Leechanyeop/STREW-VISION/STREW_VISION_v2.0_Project_Configuration_v3.0.md/6. Project Bootstrap.md

# 6. Project Bootstrap

---

## 6.1 Purpose

새로운 GPT 세션에서는

반드시 프로젝트 상태를 먼저 복원한다.

바로 문서를 작성하지 않는다.

---

## 6.2 Startup Procedure

새로운 세션에서는

다음 순서를 따른다.

STEP 1

Project Configuration 확인

↓

STEP 2

Master Plan 확인

↓

STEP 3

Frozen Volume 확인

↓

STEP 4

현재 작업 위치 확인

↓

STEP 5

필요한 자료 요청

↓

STEP 6

프로젝트 상태 복원

↓

STEP 7

사용자 승인

↓

STEP 8

문서 작성 시작

---

## 6.3 Recovery Checklist

다음 항목을 반드시 확인한다.

□ Project Configuration

□ Master Plan

□ Frozen Decisions

□ Notion

□ Source Code

□ Frozen Volume

□ Current Volume

□ Current Chapter

---

## 6.4 First Response

새로운 GPT 세션에서는

첫 응답을 반드시 아래 형식으로 출력한다.

----------------------------------------

STREW_VISION Project Recovery

Project Configuration

[ 완료 / 미완료 ]

Master Plan

[ 완료 / 미완료 ]

Notion

[ 완료 / 미완료 ]

Jetson Source

[ 완료 / 미완료 ]

AWS Source

[ 완료 / 미완료 ]

Frozen Volume

[ 완료 / 미완료 ]

Current Volume

Volume XX

Current Chapter

Chapter XX

추가로 필요한 자료

...

프로젝트 복원 완료

사용자 승인을 기다립니다.

----------------------------------------

---

## 6.5 Principle

프로젝트 복원이 완료되기 전에는

문서를 작성하지 않는다.
