Leechanyeop/STREW-VISION/JETSON_ROBOT/JETSON_NANO_YOLOV5_환경세팅.md

# Jetson Nano 4GB — YOLOv5n 환경 세팅 가이드

## 확인된 하드웨어/OS 정보

| 항목 | 값 |
|---|---|
| 보드 | Jetson Nano 4GB Developer Kit (Maxwell GPU) |
| L4T | R32.7.6 |
| JetPack | 4.6.6 |
| OS | Ubuntu 18.04.6 LTS (bionic) |
| CUDA | 10.2 |
| TensorRT | 8.2.1.8 (이미 설치됨) |
| Python | 3.6.9 (시스템 기본, 절대 3.8로 올리지 않는다 — 이유는 아래 참고) |

**왜 Python 3.6 + torch 1.10 + YOLOv5n인가**: NVIDIA는 Jetson Nano(L4T R32.x/JetPack 4.x) 계열용 CUDA 가속 PyTorch wheel을 Python 3.6까지만 배포한다(1.10.0이 마지막 3.6 지원 버전). Python 3.8용 wheel은 JetPack 5 이상(다른 세대 보드)부터 나온다. 3.8을 쓰려면 PyTorch를 CUDA 10.2에 맞춰 직접 소스빌드해야 하는데, NVIDIA 포럼에도 관련 미해결 질문이 여러 건 있을 만큼 검증된 경로가 아니다. `ultralytics`(YOLOv8+) 패키지는 Python 3.8+를 요구해서 이 보드에서 정식 경로로 못 쓴다 — 그래서 YOLOv5(구 `ultralytics/yolov5` 레포, pip 패키지 아님) + Python 3.6 조합으로 간다.

## 0. 사전 준비 — Swap + 성능 모드

빌드 중간에 메모리 부족으로 죽는 걸 막기 위해 먼저 처리한다.

```bash
# 4GB RAM으로는 torchvision 소스빌드 시 부족할 수 있음 — swap 추가
sudo systemctl disable nvzramconfig
sudo fallocate -l 8G /mnt/8GB.swap
sudo chmod 600 /mnt/8GB.swap
sudo mkswap /mnt/8GB.swap
sudo swapon /mnt/8GB.swap
# 재부팅 후에도 유지하려면 /etc/fstab 에 추가:
# /mnt/8GB.swap none swap sw 0 0

# 최대 성능 모드 (빌드/학습/추론 전부 이걸로)
sudo nvpmodel -m 0
sudo jetson_clocks
```

## 1. 시스템 라이브러리

```bash
sudo apt-get update
sudo apt-get install -y liblapack-dev libblas-dev gfortran libfreetype6-dev \
    libopenblas-base libopenmpi-dev libjpeg-dev zlib1g-dev python3-pip \
    libopenblas-dev libavcodec-dev libavformat-dev libswscale-dev libpython3-dev
```

## 2. Python 패키지 (버전 고정 — Python 3.6 호환 한계선)

```bash
# JetPack 기본 numpy 제거 후 재설치
pip3 uninstall -y numpy
pip3 install numpy==1.19.5     # Python 3.6을 지원하는 마지막 numpy 계열
pip3 install pandas==0.22.0 Pillow==8.4.0 PyYAML==3.12 scipy==1.5.4 \
    psutil tqdm==4.64.1 imutils
sudo apt install -y python3-seaborn
```

## 3. PyTorch 1.10.0 + torchvision 0.11.1

```bash
wget https://nvidia.box.com/shared/static/fjtbno0vpo676a25cgvuqc1wty0fkkg6.whl \
    -O torch-1.10.0-cp36-cp36m-linux_aarch64.whl
pip3 install 'Cython<3'
pip3 install torch-1.10.0-cp36-cp36m-linux_aarch64.whl

git clone --branch v0.11.1 https://github.com/pytorch/vision torchvision
cd torchvision
sudo python3 setup.py install
cd ..

# 확인
python3 -c "import torch, torchvision; print(torch.__version__, torch.cuda.is_available(), torchvision.__version__)"
```

## 4. PyCUDA (TensorRT 엔진을 파이썬에서 실행하려면 필요)

```bash
export PATH=/usr/local/cuda-10.2/bin${PATH:+:${PATH}}
export LD_LIBRARY_PATH=/usr/local/cuda-10.2/lib64:$LD_LIBRARY_PATH
python3 -m pip install pycuda --user
```

## 5. YOLOv5 레포 (pip install ultralytics 아님!)

```bash
git clone --branch v6.2 https://github.com/ultralytics/yolov5
cd yolov5
# requirements.txt에서 torch/torchvision 줄은 지운다 (이미 위에서 설치했으므로 pip이 덮어쓰지 않게)
pip3 install -r requirements.txt
```

## 6. 학습 → TensorRT 엔진 변환

우리 프로젝트는 식물 상태(healthy/powdery_mildew/missing_plant/empty_cell) 4개 클래스로 **직접 학습한 커스텀 가중치**가 필요하다(`nutrition_needed`는 제외 — `robot/planner.py`의 `ACTION_MAP`이 이 4개만 다루고, 매핑 안 된 값은 전부 기본값 `SKIP`으로 빠진다).

**2026-07-15 결정**: 실제로 학습이 끝난 가중치가 YOLOv8(`ultralytics`) 기준 `.pt`로 이미 존재함. 아래 6-A(YOLOv5 전용, mailrocketsystems/JetsonYolov5 기준 — `gen_wts.py`+C++ 빌드)는 v8 가중치의 레이어 구조(anchor-free head, C2f 블록 등)를 못 읽으므로 **이 프로젝트엔 해당 없음**. 대신 6-B(ONNX 경유) 경로를 쓰기로 함 — 시간이 촉박해 v5로 재학습하는 대신, 이미 있는 v8 가중치를 살리는 쪽을 선택. TensorRT 8.2.1.8이 ultralytics의 최신 ONNX export 연산(op)을 전부 지원하는지는 아직 검증 전이며, 6-B 1단계에서 실패하면 `--opset` 낮추기/`onnx-simplifier` 적용/6-A로 회귀(재학습) 중 택해야 함.

### 6-A. YOLOv5 전용 경로 (참고: mailrocketsystems/JetsonYolov5) — 현재 미사용

```bash
# .pt -> .wts 변환
python3 gen_wts.py -w best.pt -o best.wts

# TensorRT 엔진 빌드 (yolov5 C++ 추론 레포 기준)
mkdir build && cd build
cp ../../best.wts .
cmake ..
make
./yolov5_det -s best.wts best.engine n   # n = nano 모델 타입

# 테스트
./yolov5_det -d best.engine ../images
```

### 6-B. YOLOv8 → ONNX → TensorRT 경로 (현재 채택)

1단계는 **젯슨 나노가 아닌 별도 PC**(Python 3.8+, `ultralytics` 설치 가능한 환경)에서 실행한다. 2단계부터는 젯슨 나노(Python 3.6.9, TensorRT 8.2.1.8)에서 실행한다.

```bash
# [별도 PC, Python 3.8+] 1. .pt -> .onnx export
pip install ultralytics
python3 -c "
from ultralytics import YOLO
model = YOLO('best_v8.pt')
model.export(format='onnx', opset=12, simplify=True)
"
# best_v8.onnx 생성됨 -> scp 등으로 젯슨 나노에 복사

# [젯슨 나노] 2. trtexec로 우선 파싱 가능 여부부터 검증
#    (TensorRT 8.2.1.8이 이 ONNX의 연산을 다 지원하는지 여기서 바로 확인됨)
/usr/src/tensorrt/bin/trtexec --onnx=best_v8.onnx --saveEngine=best.engine --fp16

# 실패 시: opset 낮춰서 재export(예: opset=11) 또는 onnx-simplifier 재적용 후 재시도
```

**주의**: `robot/ai/detector/camera.py`의 엔진 로딩 코드(`trt.Runtime().deserialize_cuda_engine()`)는 `.engine` 파일이 어떤 경로(6-A든 6-B든)로 만들어졌든 그대로 읽을 수 있음 — 엔진 로딩 자체는 파이프라인에 무관. 다만 **출력 텐서 구조는 다를 수 있음**: YOLOv5(C++ 레포 기준)는 보통 출력이 여러 개로 분리되어 있는 반면, YOLOv8 ONNX export는 보통 출력이 단일 텐서(`[1, 4+클래스수, N]` 형태, NMS 미포함)로 나옴. 실제 추론 후처리 코드는 `best.engine`이 만들어진 뒤 `self.engine`의 바인딩 개수/shape를 실제로 찍어보고 그에 맞춰 작성해야 함(추측하지 말 것).

## 참고 자료

- [PyTorch for Jetson - NVIDIA Developer Forums](https://forums.developer.nvidia.com/t/pytorch-for-jetson/72048)
- [mailrocketsystems/JetsonYolov5 (Jetson Nano + JetPack 4.6 실제 검증됨)](https://github.com/mailrocketsystems/JetsonYolov5)
- [Faster YOLOv5 inference with TensorRT — Run YOLOv5 at 27 FPS on Jetson Nano (Seeed Studio)](https://www.seeedstudio.com/blog/2022/08/23/faster-inference-with-tensorrt-on-nvidia-jetson-run-yolov5-at-27-fps-on-jetson-nano/)
- [Install PyTorch on Jetson Nano — Q-engineering (swap 관련)](https://qengineering.eu/install-pytorch-on-jetson-nano.html)
