Leechanyeop/STREW-VISION/STREW-VISION_PM_가이드.docx

# STREW-VISION 개발 운영 가이드 (PM)

실제 리포지토리 분석 반영판 · 2026-07-02

# 0. 현재 개발 현황 요약 (Notion 문서 대조 결과)

Notion "#System Setting" 문서와 실제 로컬 리포지토리(C:\STREW_VISION)를 대조한 결과, Jetson Nano 쪽은 문서에 없는 내용까지 포함해 실제로는 더 진행되어 있는 반면, AWS/백엔드·Arduino·대시보드 쪽은 문서상 완성된 것처럼 서술되어 있으나 실제 코드는 대부분 비어 있습니다.

영역 | 문서(Notion) 서술 | 실제 리포지토리 상태 | 판정
Jetson 비전(YOLO) | YOLO는 placeholder 수준 | 학습된 가중치 존재(yolo-train-12), 추론 엔진(ai/detector/engine.py)은 NotImplementedError 스텁 | 문서와 일치 (미완성 맞음)
Jetson 로봇 제어 | strew_robot(main/agent/cloud_client/vision_source/arduino_link) 골격 | 위 파일 모두 존재 + 문서에 없는 robot/ 패키지(uart, packet, protocol, state_machine, task_manager) 추가 발견 | 문서보다 더 진행됨(미문서화)
카메라/센서 | CSI 카메라 + OpenCV 윤곽선 감지만 언급 | IMX708 리눅스 드라이버(11개 파일, 실제 커널모듈) + HuskyLens 컬러 라벨링(251줄) 존재 | 문서에 없는 항목, 실제로는 더 진행됨
AWS_SYSTEM / 백엔드 | FastAPI 7개 API, DynamoDB, Docker, Terraform 완성 | strew-backend/main.py 0줄(빈 파일), requirements.txt만 존재. Terraform/Docker 파일 없음 | 심각한 불일치 – 문서상 완성, 실제는 미착수
Arduino Mega | arduino_mega/strew_mega_receiver.ino 예제 수신부 존재 | strew-arduino/에 README.md, platformio.ini만 존재, .ino/.cpp 소스 없음 | 불일치 – 실제 코드 없음
대시보드 | Node/Express/SQLite 대시보드, API 3종 구현 | strew-dashboard/에 package.json, README만 존재, 소스코드 없음 | 불일치 – 실제 착수 전
아키텍처 문서 | 00_SYSTEM_OVERVIEW.md ~ 05_FILE_MAP.md 존재한다고 서술 | docs/Architecture에 2개 문서만 존재(JETSON_AWS_MEGA_INTEGRATION_PLAN, JETSON_ROBOT_STRUCTURE_SUMMARY) | 불일치 – 서술된 문서 없음
docker-compose.yml | 언급 없음 | 루트에 존재하나 내용 0바이트(빈 파일) | 방치된 빈 설정 파일

결론: 프로젝트 전체를 놓고 보면 "Jetson Nano 파트"가 가장 실체가 있는 영역이며, 오히려 문서에 기록되지 않은 하드웨어 드라이버·로봇 상태머신·YOLO 학습 산출물까지 존재합니다. 반면 문서가 완성됐다고 서술한 백엔드/Arduino/대시보드는 사실상 스캐폴딩(폴더+빈 파일) 수준입니다. 아래 STEP별 가이드는 이 실제 상태를 기준으로 다시 작성되었습니다.

# STEP 1. 프로젝트 목표 정의

프로젝트명: STREW-VISION

목적: 딸기 생육 상태와 질병을 AI Vision(YOLO 객체 탐지 + HuskyLens 컬러 인식)으로 분석하고, Jetson Nano와 Arduino Mega2560을 이용해 로봇이 자동으로 관찰·방제 작업을 수행하는 온실 자동화 시스템 구축

기능 목록

- 잎/열매 검출 (YOLO 기반 – 학습 완료, 추론 파이프라인 미연결)
- QR·컬러 인식 (HuskyLens 기반 – 부분 구현)
- Jetson ↔ Arduino UART 통신 (패킷/프로토콜 – 스캐폴딩 수준)
- 로봇 상태 관리 (상태 머신·작업 관리자 – 구현 진행 중)
- 클라우드 연동 (API 클라이언트 구현, MQTT/동기화 – 미구현)
- 대시보드 모니터링 (미착수)

최종 결과물

Jetson Nano의 실시간 비전 분석 결과를 UART로 Arduino Mega2560에 전달 → Arduino가 로봇 동작(모터/그리퍼 등)을 실행 → 처리 결과를 백엔드·대시보드에 보고하는 통합 온실 자동화 로봇 시스템

개발 범위 (실제 리포지토리 기준)

- JETSON_ROBOT – 비전/AI, 로봇 제어, 클라우드 연동 (가장 진척됨)
- strew-arduino – Arduino Mega2560 펌웨어 (착수 전)
- strew-backend – 서버/API (착수 전)
- strew-dashboard – 모니터링 대시보드 (착수 전)
- strew-hardware – BOM/CAD/PCB/배선 자료
- docs – 아키텍처 문서

# STEP 2. 요구사항 정의 (실제 구현 상태 포함)

AI가 가장 먼저 읽는 문서. 각 요구사항에 현재 구현 상태를 명시해 실제 착수 우선순위를 판단할 수 있도록 함.

ID | 요구사항 | 현재 상태
REQ-001 | 잎을 검출해야 한다 | 부분 구현 – YOLO 학습 데이터/가중치 존재, 추론 엔진 미연결(스텁)
REQ-002 | 열매를 검출해야 한다 | 부분 구현 – 위와 동일
REQ-003 | QR/컬러를 인식해야 한다 | 부분 구현 – huskylens_color_labels.py(251줄) 구현, ai/qr 모듈은 빈 스텁
REQ-004 | Jetson은 UART Packet을 생성한다 | 스캐폴딩 – robot/packet.py(6줄), protocol.py(3줄)만 존재, 실제 포맷/체크섬 로직 없음
REQ-005 | Arduino는 ACK를 반환한다 | 미구현 – strew-arduino에 실제 소스코드 없음(README/설정파일뿐)
REQ-006 | Jetson 로봇은 백엔드 서버와 통신한다 | 부분 구현 – cloud_client.py/api_client.py 존재하나 대상 백엔드(strew-backend)가 비어있어 실연동 불가
REQ-007 | CSI 카메라(IMX708)를 인식해야 한다 | 구현됨 – 리눅스 드라이버 소스 11개 파일 존재
REQ-008 | 로봇은 상태 머신으로 작업을 관리한다 | 구현 진행 중 – state_machine.py(75줄), task_manager.py(19줄)
REQ-009 | 백엔드는 로봇 작업 요청/응답 API를 제공한다 | 미구현 – strew-backend/main.py 빈 파일
REQ-010 | 모니터링 대시보드를 제공한다 | 미구현 – strew-dashboard 소스코드 없음

# STEP 3. 디렉터리 구조 정의 (실제 구조 기준)

Architecture Agent가 설계를 맡되, 아래는 현재 실제 리포지토리 구조와 각 폴더의 실질 역할·완성도임.

폴더 | 역할 | 완성도
JETSON_ROBOT/ai | 비전 처리(YOLO detector, QR/segmentation/tracker) | 대부분 스텁 (camera.py만 실구현 96줄)
JETSON_ROBOT/robot | 로봇 제어(UART, 패킷, 상태머신, 작업관리) | 스캐폴딩~부분 구현
JETSON_ROBOT/cloud | 클라우드/백엔드 통신(API, MQTT, 동기화) | api_client만 구현, mqtt/sync 미구현
JETSON_ROBOT/JETSON | IMX708 카메라 드라이버, HuskyLens 연동 | 구현됨
JETSON_ROBOT/strew_robot | 레거시 로봇 에이전트(main/agent/cloud_client/vision_source/arduino_link) | 구현됨 – robot/ai와 역할 중복, 정리 필요
JETSON_ROBOT/tests | 테스트 코드 + YOLO 학습 산출물 | 학습 산출물(yolo-train-12) 존재
strew-arduino | Arduino Mega2560 펌웨어 | PlatformIO 뼈대만 존재, 코드 없음
strew-backend | 서버/API(FastAPI 등) | main.py 빈 파일, 미착수
strew-dashboard | 모니터링 대시보드 | package.json/README만 존재, 미착수
strew-hardware | BOM/CAD/PCB/배선/데이터시트 | 자료 보유
docs | 아키텍처 문서 | 2개 문서만 존재(Notion 서술과 불일치)
strew-jetson | 용도 불명 – README만 존재 | JETSON_ROBOT과 이름 중복, 정리 대상

주의: strew_robot(레거시)과 robot/ai(신규)가 유사 기능을 중복 구현 중인 것으로 보이므로, Architecture Agent는 다음 작업으로 통합 여부를 먼저 판단해야 함.

# STEP 4. 개발 규칙 정의

신규 코드부터 아래 규칙을 일괄 적용 권장 (기존 스텁 파일 리팩터링 시에도 동일 적용):

- Python 3.10+ (Jetson), Python 3.11 (백엔드)
- PEP8 준수
- Type Hint 필수
- Google Style Docstring – 모든 함수 작성
- Exception 처리 필수 (빈 raise NotImplementedError 상태로 방치 금지)
- print() 금지, logging 사용
- Relative Import 금지
- 빈 스텁 파일은 TODO 주석과 이슈 번호를 명시해 추적

# STEP 5. Agent 역할 정의

### Architecture Agent

- 프로젝트 구조만 설계한다
- 코드는 작성하지 않는다
- 현재 strew_robot ↔ robot/ai 중복 구조 정리안을 최우선 산출물로 제시한다

### Coding Agent

- 설계된 구조만 사용한다
- 새 폴더 생성 금지
- 새 라이브러리 추가 금지

### Validation Agent

- Import, Directory, Dependency, File Missing, API 연결 여부 검사
- 빈 파일(0바이트)·스텁 함수(NotImplementedError) 목록화

# STEP 6. 개발 순서 정의 (현재 진척도 반영 재조정)

기존 예시 순서(Architecture → Vision → Disease → QR → Motion → UART → Arduino → Dashboard → Integration → Deployment)는 Vision/Motion 쪽이 이미 일부 진행된 현재 상태와 맞지 않음. 공백 영역을 우선순위로 재조정:

- 1. strew-backend API 구현 (완전 공백 – 병목 지점)
- 2. strew-arduino 펌웨어 구현 (완전 공백)
- 3. Jetson AI 추론 파이프라인 완성 (ai/detector 스텁 → YOLO 가중치 연결)
- 4. Jetson robot/ 제어 로직 완성 (packet/protocol/motion)
- 5. strew_robot(레거시) ↔ robot/ai 통합 정리
- 6. Cloud 연동 완성 (mqtt, sync)
- 7. Dashboard 구현
- 8. 통합 테스트 → 배포

# STEP 7. AI에게 작업 지시 (예시)

항목 | 내용
Task | strew-backend FastAPI 서버 구현
범위 | strew-backend/
조건 | Python 3.11, FastAPI, Pydantic, Uvicorn
완료 기준 | GET /health, POST /robot/request, GET /robot/next, POST /robot/response 4개 엔드포인트 동작
출력 | JSON REST API

# STEP 8. 구현 후 검증

Validation Agent 검사 항목:

- 파일 누락 여부 (특히 0바이트 스텁 파일)
- Import / Dead Code
- Dependency
- Naming / SOLID
- Exception 처리
- Memory Leak
- 문서(Notion 등)와 실제 코드 상태 일치 여부 – 이번 대조에서 드러난 것처럼 정기적 대조 필요

# STEP 9. 수정

Review Agent → 문제점만 작성 (코드 수정 금지)

Coding Agent → Review 결과만 수정

# STEP 10. 최종 통합

Integration Agent 검사 항목: UART, Vision, Motion, Arduino, Dashboard, Database, Logger

현재 상태 기준 통합 전 필수 선행 작업: strew-backend/Arduino 실제 구현, strew_robot↔robot 중복 제거

# STEP 11. 최종 테스트

Vision → QR → Task → Motion → UART → Arduino → Servo → DONE (성공하면 Release)

# 핵심 역할

역할 | 사람(PM)이 할 일 | AI가 할 일
PM | 요구사항 정의 | -
Architect | 전체 구조 승인 | 구조 제안
Task Manager | 작업 분배 | 작업 수행
Reviewer | 결과 승인 여부 결정 | 리뷰 결과 생성
Integrator | 최종 통합 판단 | 통합 지원

# 추천 운영 사이클

- ① 요구사항 작성
- ② Claude Code (설계/분석)
- ③ Codex (구현)
- ④ Claude Code (리뷰/검증)
- ⑤ Codex (수정)
- ⑥ Claude Code (최종 승인)
- ⑦ Git Commit
- ⑧ 다음 기능 개발

# 가장 중요한 원칙

AI에게 "코드를 만들어줘"라고 지시하기보다, "무엇을 만들고, 어떤 제약을 지켜야 하며, 완료 기준이 무엇인지"를 먼저 정의하는 것이 핵심이다.

매 기능마다 다음 5가지를 먼저 정하면 결과 품질이 크게 좋아진다:

- 목표: 무엇을 구현하는가?
- 입출력: 입력과 출력은 무엇인가?
- 제약: 사용할 기술, 금지 사항, 코딩 규칙은?
- 완료 기준: 언제 구현이 끝났다고 볼 것인가?
- 검증 방법: 어떤 테스트를 통과해야 승인할 것인가?

이 다섯 가지를 기준으로 Claude Code에는 설계와 검증을, Codex에는 구현을 맡기면 프로젝트를 훨씬 안정적으로 운영할 수 있다.
