Leechanyeop/STREW-VISION/docs/25년_SW개발_HW제작설계서_응용하드웨어(개인정보 기재x).pptx

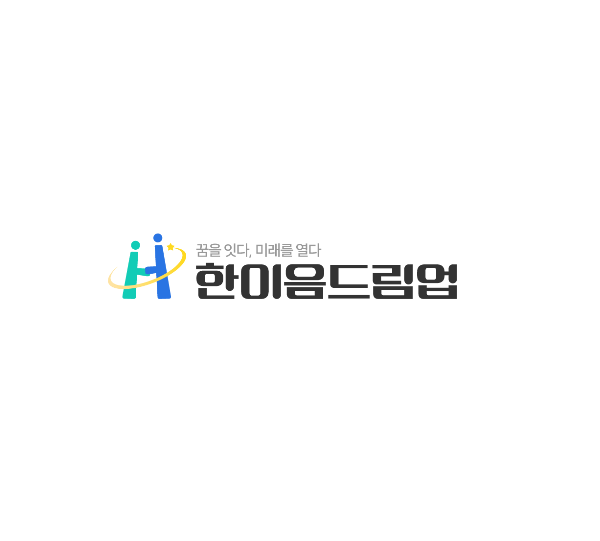
[picture p1: figure]

SW개발/HW제작 설계서
STREW_VISION ARCHITECHER
SW/HW DEVELOPMENT

프로젝트 명 : STREW_VISION

## Slide 2

수행 단계별 주요 산출물

단계 | 선정 산출물 | 우선 | 구체화 필요도 | 비고
환경 분석 | 시장/기술 환경 분석서 | △ | 중 | 농업 인력난, 병해충 조기 대응, 스마트팜 동향 중심
요구사항 분석 | 요구사항 정의서 | ◎ | 상 | S/W, H/W, 운영자 요구사항을 기능 ID로 연결
요구사항 분석 | 유즈케이스 정의서 | ◎ | 상 | 운영자, ,Jetson, 로봇 제어부 역할 정의
아키텍처 설계 | 시스템 구성도 | ◎ | 상 | 센서 → STM32 → Jetson → DB → 로봇제어부 흐름
아키텍처 설계 | 데이터 흐름도 | ◎ | 상 | 주행 시작부터 검사/로그 저장까지 이벤트 흐름
아키텍처 설계 | 하드웨어/센서 구성도 | ◎ | 상 | 온습도 센서 4개, 리미트 스위치 4개, 카메라, 제어부
기능 설계 | 화면 설계서 | ○ | 중 | 위치, 센서값, 검사결과, 로그, 비상정지/재개 UI
기능 설계 | ERD/테이블 정의서 | ◎ | 상 | pot, sensor_reading, robot_position_log, vision_inspection_log 등
기능 설계 | 기능 처리도 | ◎ | 상 | ARRIVED → PLANT_ID → 비전검사 → 판정 → 로그
기능 설계 | 알고리즘 명세서 | ◎ | 상 | LIMIT 매핑, 검사 조건, discard 판단, 예외 처리
개발/구현 | 프로그램 목록 | ○ | 중 | COM/POS/SNS/VIS/DEC/CTRL/LOG 모듈 목록
개발/구현 | 핵심 소스코드 | ◎ | 상 | STM32 수신, 식물 ID 판별, 비전 검사, STOP/RESUME 처리
검증 | 비상정지/재개 시나리오 | ◎ | 상 | 안전 우선순위와 재개 전 위치 재확인

※ ○ 필수, △ 선택

## 환경 및 요구사항 분석

한이음 ▶ 프로그램 설계서

## Slide 4

| 시장/기술 동향 분석

작성 범위 세분화

시장/기술 동향 분석은 “범위 정의 → 시장 Fact → 기술 Fact → 종합 판단” 순서로 작성

각 슬라이드는 객관적 근거 제시, 정량·정성 병행, 마지막 사업화 시사점 도출이라는 동일한 작성 원칙을 따릅니다.

분석 목적·범위

대상 시장, 고객군, 지역, 적용 제품/서비스를 먼저 고정

시장 동향

시장 규모, 수요 변화, 경쟁 구도, 정책·규제를 정리

기술 동향

핵심 기술, 성숙도, R&D·특허·표준, 구현 이슈를 정리

종합 판단

시장 매력도와 기술 실현 가능성을 교차 평가해 실행 제언 도출

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
작성 체크포인트: 출처/기준연도 명시 · 비교 대상 통일 · Fact와 해석 분리 · 기회/위험을 실행 과제로 연결

## Slide 5

| 시장/기술 동향 분석

단순 현황 나열보다 “왜 지금 진입해야 하는가 / 어디가 유망한가
/ 무엇이 리스크인가”가 드러나야 합니다.

A. 시장 규모·성장성

필수 근거
• 공신력 있는 통계/보고서/시장조사 자료
• 최근 3개년 매출·투자·수출입·정책 변화
• 고객/경쟁사 사례 또는 실제 적용 레퍼런스

향후 3~5년간 스마트팜 시장은 단순한 환경 모니터링(1세대)을 넘어, '에지 AI + 로봇 제어 + 클라우드'가 결합된 지능형 자동화(2~3세대) 단계로 진입하며 매년 두 자릿수(11%~15%)의 높은 CAGR을 기록할 것으로 강력히 전망됩니다.

B. 고객 수요·구매 요인

• 전체 시장 규모: 기준연도, 지역, 금액/수량 단위
• 성장성: CAGR, 3~5년 전망, 성장 요인
• 세그먼트: 고객군·용도·가격대별 비중
• 근거: 통계청, 산업보고서, 협회/공공 데이터

산출물 예시
시장 매력도 평가표 | 경쟁사 포지셔닝 맵 | 진입 우선순위

작성 문장 예시: “OO 시장은 △△ 수요 증가와 □□ 정책 지원으로 성장성이 높으나, 인증·유통 장벽이 초기 진입 리스크로 작용한다.”

## Slide 6

| 시장/기술 동향 분석

세부 양식 ①

단순 현황 나열보다 “왜 지금 진입해야 하는가 / 어디가 유망한가 / 무엇이 리스크인가”가 드러나야 합니다.

B. 고객 수요·구매 요인

필수 근거
• 공신력 있는 통계/보고서/시장조사 자료
• 최근 3개년 매출·투자·수출입·정책 변화
• 고객/경쟁사 사례 또는 실제 적용 레퍼런스

• 핵심 고객: B2B/B2C, 의사결정자, 사용 부서
• Pain Point: 비용, 품질, 납기, 안전, 편의성
• 구매 요인: 가격 민감도, 인증, 브랜드, 사후관리
• 변화 신호: 검색량, 입찰/수주, VOC, 레퍼런스

산출물 예시
시장 매력도 평가표 | 경쟁사 포지셔닝 맵 | 진입 우선순위

작성 문장 예시: “OO 시장은 △△ 수요 증가와 □□ 정책 지원으로 성장성이 높으나, 인증·유통 장벽이 초기 진입 리스크로 작용한다.”

## Slide 7

| 시장/기술 동향 분석

세부 양식 ①

단순 현황 나열보다 “왜 지금 진입해야 하는가 / 어디가 유망한가 / 무엇이 리스크인가”가 드러나야 합니다.

C. 경쟁 구도·대체재

필수 근거
• 공신력 있는 통계/보고서/시장조사 자료
• 최근 3개년 매출·투자·수출입·정책 변화
• 고객/경쟁사 사례 또는 실제 적용 레퍼런스

산출물 예시
시장 매력도 평가표 | 경쟁사 포지셔닝 맵 | 진입 우선순위

• 주요 기업: 점유율, 제품군, 가격, 채널
• 경쟁 우위: 기술, 원가, 브랜드, 파트너십
• 대체재/보완재: 기존 방식 대비 강·약점
• 비교 산출물: 경쟁사 포지셔닝 맵

작성 문장 예시: “OO 시장은 △△ 수요 증가와 □□ 정책 지원으로 성장성이 높으나, 인증·유통 장벽이 초기 진입 리스크로 작용한다.”

## Slide 8

| 시장/기술 동향 분석

세부 양식 ①

단순 현황 나열보다 “왜 지금 진입해야 하는가 / 어디가 유망한가 / 무엇이 리스크인가”가 드러나야 합니다.

D. 정책·규제·진입장벽

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

C. 경쟁 구도·대체재

• 정책/지원사업: 정부 과제, 보조금, 공공조달
• 규제/인증: 표준, 안전, 환경, 개인정보
• 진입장벽: 설비투자, 유통망, 전환비용
• 최종 판단: 기회·위험·대응 전략

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

## Slide 9

| 시장/기술 동향 분석

딸기 스마트팜 시장은 겨울철 고품질 딸기 수요 증가와 정부의 청년·창업농 정책 지원으로 성장성이 높으나, 초기 고액의 시설 구축 비용과 ICT 인증 기자재 수급 장벽이 초기 진입 리스크로 작용한다.”

작성 목적: 시장 매력도와 기술 실현 가능성을 동시에 검토하여 사업화 우선순위를 판단

② 기술 동향 작성 항목

1) 핵심 기술 정의: 기술 원리, 구성요소, 적용 범위
2) 성숙도: TRL, 상용화 수준, 성능/원가/품질 지표
3) R&D 흐름: 논문·특허·표준화·정부 과제 동향
4) 주요 플레이어: 선도 기업/기관, 보유 기술, 협업 구조
5) 구현 이슈: 개발 난이도, 공급망, 보안·안전·인증 이슈
6) 시사점: 확보 전략, 내재화/제휴/도입 판단 기준

필수 근거
• 특허·논문 증가율, 표준/인증 변화
• 벤치마크 성능, 원가 구조, 양산 가능성
• 경쟁 기술 대비 우위·한계 및 대체 가능성

산출물 예시
기술 성숙도 매트릭스 | 특허/논문 트렌드 | 확보 로드맵

최종 작성 구조: ① 분석 배경 → ② 시장/기술 Fact → ③ 경쟁·규제 비교 → ④ 기회/위험 → ⑤ 실행 제언

## Slide 10

| 시장/기술 동향 분석

기술 설명은 원리보다 사업화 판단에 필요한 성능, 원가, 특허/표준, 구현 리스크 중심으로 정리합니다.

기술 동향은 성숙도와 확보 가능성을 분리해 “내재화·제휴·도입” 판단으로 연결합니다

A. 기술 정의·성숙도

1) 핵심 기술 정의
- 기술 원리, 구성요소, 적용 제품/서비스
- 기존 기술 대비 차별점

2) 성숙도·상용화 수준
- TRL, 양산/실증 여부, 레퍼런스
- 성능·원가·품질 기준 및 벤치마크

3) 구현 이슈
- 공급망, 장비/소재, 보안·안전·인증
- 개발 난이도와 예상 소요 기간

B. R&D 흐름·확보 전략

1) R&D·특허·논문 동향
- 최근 3~5년 출원/발표 증가율
- 주요 출원인, 기술 분류, 표준화 움직임

2) 주요 플레이어·협업 구조
- 선도 기업/기관, 파트너십, 공급망 위치
- 보유 기술과 약점 비교

3) 확보 전략
- 자체 개발, 공동개발, 라이선스, M&A
- 비용·기간·리스크 기준 우선순위

산출물: 기술 성숙도 매트릭스 / 성능 비교표 / 구현 리스크 목록

산출물: 특허/논문 트렌드 / 기술 확보 로드맵 / Make-Buy-Partner 판단표

## Slide 11

| 요구사항 정의서

요구사항 ID | 요구사항명 | 상세 내용 | 입력 데이터 | 처리 내용 | 출력 결과
FR-01 | 하우스 온·습도 측정 | 온·습도 센서를 통해 하우스 내부 환경 데이터를 측정한다. | 온도 센서값, 습도 센서값 | 센서 데이터 수집 및 변환 | 온도·습도 측정값
FR-02 | 상위 제어 명령 수행 | 상위 제어기에서 전달된 작업 명령을 수신하고 로봇 동작 명령으로 변환한다. | 상위 제어 명령 | 명령 해석 및 동작 변환 | 로봇 제어 명령
FR-03 | 6축 로봇 제어 | 6축 로봇을 지정 위치로 이동시켜 보식 작업을 수행하도록 제어한다. | 좌표값, 작업 명령 | 로봇 경로 생성 및 위치 제어 | 로봇 이동 및 작업 수행
FR-04 | 식물 보식 여부 판단 | 식물 삽입, 위치 정렬, 작업 완료 여부 확인 등 실제 보식 동작을 처리한다. | 보식 대상 위치, 식물 정보 | 식물 삽입 및 정렬 작업 수행 | 보식 완료 결과
FR-05 | 비전 인식 촬영 제어 | 비전 센서가 바코드와 식물을 인식할 수 있도록 촬영 위치와 모션을 제어한다. | 촬영 위치, 모션 명령 | 카메라 위치 제어 및 촬영 수행 | 바코드·식물 이미지
FR-06 | 인식 데이터 연동 | 바코드 및 식물 인식 결과를 상위 시스템에 전달하고 작업 이력으로 저장한다. | 바코드 인식값, 식물 인식 결과 | 데이터 전송 및 이력 저장 | 인식 결과, 작업 이력 데이터

## Slide 12

| 요구사항 정의서

FR-06 | 생장 환경 최적화 제어 | 측정된 온·습도 값을 목표값과 비교하고 PID 제어를 수행한다. | 온도, 습도, 목표 설정값 | PID 제어 알고리즘 수행 | 냉난방기, 가습기, 환풍기 제어 명령
FR-07 | 이상 상태 알림 | 위험 상태 또는 병해충 발생 시 관리자에게 알림을 전송한다. | AI 분석 결과 | 이벤트 감지 및 알림 생성 | 앱 알림, SMS, 경고 메시지
FR-08 | 데이터 저장 및 이력 관리 | 센서 데이터 및 분석 결과를 데이터베이스에 저장한다. | 센서 데이터, 분석 결과 | DB 저장 및 이력 관리 | 조회 가능한 이력 데이터

## Slide 13

| 요구사항 정의서

요구사항 ID | 요구사항명 | 상세 내용
NFR-01 | 실시간성 | 센서 데이터는 1분 이내 주기로 갱신되어야 한다.
NFR-02 | 정확성 | AI 병해충 판별 정확도는 90% 이상이어야 한다.
NFR-03 | 안정성 | 시스템 가동률은 99% 이상을 유지해야 한다.
NFR-04 | 사용성 | 관리자 화면에서 모든 셀의 상태를 한 화면에서 확인할 수 있어야 한다.
NFR-05 | 보안성 | 사용자 로그인 및 권한 관리 기능을 제공해야 한다.

## Slide 14

| 요구사항 정의서

요구사항 ID | 요구사항명 | 상세 내용
NFR-01 | 측정 정확성 | 온·습도 센서는 일정 오차 범위 내에서 하우스 환경을 측정해야 한다.
NFR-02 | 제어 응답성 | 상위 제어 명령 수신 후 로봇 동작 명령으로 빠르게 변환되어야 한다.
NFR-03 | 동작 안정성 | 6축 로봇은 지정된 작업 범위 내에서 안전하게 동작해야 한다.
NFR-04 | 인식 정확성 | 바코드 및 식물 인식 결과는 작업 처리에 활용 가능한 수준의 정확도를 가져야 한다.
NFR-05 | 이력 관리 | 보식 작업 결과와 인식 데이터는 추후 조회가 가능하도록 저장되어야 한다.

## Slide 15

| 요구사항 정의서

요구사항 ID | 요구사항명 | 상세 내용 | 입력 데이터 | 처리 내용 | 출력 결과
FR-01 | 하우스 식물 온·습도 상태 조회 | 최근 7일간 누적된 온도 및 습도 데이터를 조회하고 그래프로 시각화한다. | 온도 센서 데이터, 습도 센서 데이터 | 일별 데이터 수집 및 그래프 생성 | 온도·습도 추이 그래프
FR-02 | 식물셀 상시 모니터링 | 4개 식물셀의 상태를 실시간으로 감시하고 병해충 발생 여부를 확인한다. | 카메라 영상, 환경 센서 데이터 | 이미지 분석 및 상태 판별 | 식물 상태 정보, 병해충 발생 알림
FR-03 | AI 드라이브 자동 판단 | 설정된 임계값을 초과한 경우 AI가 자동으로 상태를 분석하여 위험 여부를 판단한다. | 환경 데이터, 식물 상태 데이터, 임계값 | AI 모델 기반 위험도 분석 | 정상/주의/위험 상태 결과
FR-04 | 보식 작업 결정 | AI 분석 결과를 기반으로 문제가 발생한 식물셀의 보식 필요 여부를 결정한다. | AI 분석 결과, 식물 상태 정보 | 보식 필요성 판단 알고리즘 수행 | 보식 필요 여부 및 대상 셀
FR-05 | 성장률 및 생산성 분석 | 보식 날짜를 기준으로 식물셀별 평균 성장률과 전체 생산성을 계산한다. | 보식 이력, 생육 데이터 | 성장률 계산 및 생산성 분석 | 셀별 성장률, 생산성 지표

## Slide 16

| 유즈케이스 정의서

사용자가 시스템으로 무엇을 하는지 시나리오로 정리

UC-01 온실 환경 확인 및 제어

기본 정보

관리자가 온실 상태를 확인하고 필요 시 제어한다

농장 관리자 / 운영 담당자

관리자가 시스템에 로그인되어 있음

현재 상태 확인 또는 제어 명령이 정상 반영됨

기본 흐름

1. 대시보드에서 온실 선택
2. 온도·습도·CO₂·조도 확인
3. 이상 항목 경고 확인
4. 관수/환기/난방 제어 실행
5. 실행 결과와 이력 저장

예외/확장

• 센서 값 미수신 시 데이터 없음 표시
• 장비 응답 실패 시 재시도 및 알림
• 자동제어 모드에서는 기준값에 따라 실행

목적

사용자

시작 조건

완료 조건

유즈케이스 → 사용자 행동 흐름 정리 → 기능 요구사항 도출의 근거

핵심: 유즈케이스는 “사용 장면과 흐름”을 보여준다.

## Slide 17

| 요구사항 정의서

시스템이 제공해야 할 기능과 품질 조건을 목록으로 정의

딸기 스마트팜 시스템 요구사항 예시

기능 요구사항

온실별 환경 데이터를 조회할 수 있어야 한다

기준치 이탈 시 관리자에게 알림을 발송해야 한다

관수·환기·난방 장치를 수동/자동 제어해야 한다

생육·환경 데이터를 기간별 그래프로 제공해야 한다

비기능 요구사항

NFR-01 센서 데이터 5분 단위 수집
NFR-02 모바일/PC 동일 기능 제공
NFR-03 장애 발생 시 1분 내 알림
NFR-04 사용자 권한별 접근 제한
NFR-05 제어/알림 이력 1년 보관

검수 기준

• 테스트 계정으로 데이터 조회 확인
• 임계값 초과 시 알림 수신 확인
• 제어 명령 후 장비 상태 변경 확인
• 요구사항별 우선순위와 담당자 지정

FR-01

FR-02

FR-03

FR-04

요구사항 → 기능/품질 조건 확정 → 설계·개발·검수 기준으로 사용

핵심: 요구사항 정의서는 “만들 기능과 조건”을 확정한다.

최종 산출물: 요구사항 목록표 + 유즈케이스 상세표 + 요구사항-유즈케이스 추적표

## 시스템 아키텍쳐설계 (system architecture configuration)

## Slide 19

| 서비스 구성도 - 서비스 시나리오

## Slide 20

서비스 구성도 – 시스템 계층

시스템은 총 9개 계층으로 구성됨.
1.물리/필드 계층 - 딸기 작물, 화분, 레일 등 실제 농장 환경
2.로봇/제어 계층 - 자율주행 로봇과 로봇 팔을 제어한다.
3.센서/수집 계층 - 카메라와 센서로 이미지와 위치 정보를 수집.
4.인식 계층 - QR코드를 통해 화분 ID를 식별.
5.AI 분석 계층 - 작물 이미지를 분석하여 병해충 여부를 판단.
6.데이터/저장 계층 - 분석 결과와 작업 이력을 DB에 저장.
7.응용 계층 - 자동 관리 사이클과 작업 로직을 처리.
8.서비스/관제 계층 - 웹/모바일 화면으로 상태를 시각화.
9.사용자 계층 - 관리자가 확인과 의사결정을 수행.

## Slide 21

서비스 흐름도 - DATA FLOW

## Slide 22

| 참조-개발 환경 및 설명

구분 | | 항목 | 적용내역
H/W 구성장비

## Slide 23

| 참조-개발 환경 및 설명

구분 | | 항목 | 적용내역
H/W 구성장비

## Slide 24

| 참조-개발 환경 및 설명

구분 | | 항목 | 적용내역
S/W 개발환경 | SDK 공동 개발 | VSCode | 본 프로젝트에서는 소스코드 작성과 프로젝트 파일 관리를 위해 VSCode를 사용한다. VSCode는 다양한 프로그래밍 언어를 지원하며, Python, Arduino, HTML, JavaScript 등 프로젝트에 필요한 여러 개발 환경을 하나의 편집기에서 관리할 수 있다.
| | Git | 소스코드와 프로젝트 파일을 관리한다. Git은 코드의 변경 이력을 저장할 수 있어, 개발 과정에서 어떤 부분이 수정되었는지 쉽게 확인할 수 있다.
| | Uduntu 18.04 | 개발 환경 구축이 비교적 안정적이고, 오픈소스 도구와의 호환성이 좋아 Git, Python, AI 모델, 서버 관련 프로그램을 사용하기에 적합하다.
| | Python 3.11 | AWS 서버와 Jetson 로봇 에이전트의 주 개발 언어입니다. AWS_SYSTEM에서는 FastAPI 서버를 돌리고, JETSON_ROBOT에서는 카메라 입력, AWS 통신, Arduino 시리얼 통신을 처리합니다.
| | FastAPI | AWS 쪽 로봇 작업 API 서버를 만드는 프레임워크입니다. 로봇 작업 등록, 다음 작업 전달, 작업 결과 저장, 비전 이벤트 저장 같은 REST API를 제공합니다.
| | Uvicorn | FastAPI 앱을 실제로 실행하는 Python 웹 서버입니다. 로컬에서는 http://localhost:8000으로 API와 대시보드를 띄우는 역할입니다.
| | Pydantic | API에서 주고받는 데이터 형식을 검증합니다. 예를 들어 robot_id, execute_task, move_sign, completion_sign 같은 값들이 정해진 구조로 들어오는지 확인합니다.

## Slide 25

| 참조-개발 환경 및 설명

구분 | | 항목 | 적용내역
S/W 개발환경 | AWS_SYSTEM 서버 애플리케이션 개발 | boto3 | Python에서 AWS 서비스를 쓰기 위한 SDK입니다. 현재 구조에서는 AWS 배포 시 DynamoDB에 작업/응답/비전 이벤트를 저장하는 데 사용됩니다.
| | Docker | AWS 서버를 컨테이너 이미지로 포장하는 도구입니다. AWS_SYSTEM FastAPI 서버를 ECS Fargate에 올릴 수 있는 실행 단위로 만듭니다.
| | Terraform | AWS 인프라를 코드로 만드는 도구입니다. VPC, Subnet, Load Balancer, ECS Fargate, DynamoDB, IAM, CloudWatch 같은 리 소스를 자동 생성합니다.
| | AWS CLI | 터미널에서 AWS 계정과 ECR/ECS 등을 조작하는 도구입니다. Docker 이미지를 ECR에 로그인해서 push하거나 배포 준비를 할 때 필요
| | AWS ECR | Docker 이미지를 저장하는 AWS 컨테이너 저장소입니다. FastAPI 서버 이미지를 올려두고 ECS가 그 이미지를 가져가 실행합니다
| | AWS ECS Fargate | Docker 컨테이너를 서버 없이 실행하는 AWS 서비스입니다. 현재 FastAPI API 서버를 클라우드에서 계속 실행시키는 역할입니다.
| | Node.js | 기존 jetson_greenhouse_system/ 대시보드 서버를 실행하는 런타임입니다. FastAPI와 별도로 Express 기반 모니터링 서버가 구현되어 있습니다.

## Slide 26

| 참조-개발 환경 및 설명

구분 | | 항목 | 적용내역
S/W 개발환경 | | DynamoDB | AWS에서 사용하는 NoSQL 데이터베이스입니다. 로봇 작업, 응답, 비전 이벤트를 운영 환경에서 저장합니다.
| JETSON NANO 애플리케이션 개발 | OpenCV | Jetson Nano에서 CSI 카메라 영상을 읽고 기본 비전 처리를 하는 도구입니다. 현재는 YOLO 대신 가장 큰 윤곽선을 찾아 물체 중심 좌표를 만드는 데 사용됩니다.
| | v4l-utils | Jetson에서 카메라 장치 상태를 확인하는 리눅스 도구입니다. /dev/video0 같은 CSI 카메라가 정상 인식되는지 확인합니다.
| | pyserial | Jetson과 Arduino Mega가 USB 시리얼로 통신할 때 쓰는 Python 라이브러리입니다. Jetson이 JSON 명령을 Arduino로 보내고, Arduino 응답을 읽습니다.
| | Arduino IDE / Arduino CLI | Arduino Mega에 제어 코드를 업로드하는 개발도구입니다. Jetson에서 온 JSON 명령을 받아 모터, 그리퍼, 센서 제어 코드로 연결하는 역할입니다.
| | systemd | Jetson 부팅 시 로봇 에이전트를 자동 실행하는 리눅스 서비스 관리자입니다. strew-robot-agent.service가 이 역할을 합니다.
| | Express | Node.js 기반 웹 API 서버 프레임워크입니다. 기존 대시보드에서 /api/dashboard, /api/readings, /api/randomize 같은 API를 제공합니다.

## 하드웨어 기능 설계 ( Hardware funtion design )

## Slide 28

| 참조-H/W 기능 실사 사진

## Slide 29

| 참조-H/W 기능 실사 사진

## Slide 30

| 하드웨어 설계도

샘플 1

※ 본문의 예시 내용을 지우고 과제 내용으로 변경하여 사용하세요

## Slide 31

| 하드웨어 설계도

샘플 1

※ 본문의 예시 내용을 지우고 과제 내용으로 변경하여 사용하세요

## Slide 32

| 하드웨어 설계도

샘플 1

※ 본문의 예시 내용을 지우고 과제 내용으로 변경하여 사용하세요

## Slide 33

| 하드웨어 설계도

샘플 1

※ 본문의 예시 내용을 지우고 과제 내용으로 변경하여 사용하세요

## Slide 34

| 하드웨어 설계도

샘플 1

※ 본문의 예시 내용을 지우고 과제 내용으로 변경하여 사용하세요

## Slide 35

| 하드웨어 설계도

샘플 1

※ 본문의 예시 내용을 지우고 과제 내용으로 변경하여 사용하세요

## Slide 36

| 하드웨어 설계도

샘플 1

※ 본문의 예시 내용을 지우고 과제 내용으로 변경하여 사용하세요

## Slide 37

| 하드웨어/센서 구성도

샘플 1

센서 종류 | 연결 핀 | 설명
Neopixel Ring | GND | 아두이노의 GND에 연결
| VCC | 아두이노의 3.3V에 연결
| IN | 아두이노 4번 핀에 연결
TSL2561 | GND | 아두이노의 GND에 연결
| VCC | 아두이노의 3.3V에 연결
| SDA | 아두이노 A5 핀에 연결
| SCL | 아두이노 A4 핀에 연결
Relay module | VCC | 아두이노의 5V에 연결
| GND | 아두이노의 GND에 연결
| IN1 | 1번 아두이노 2번 핀에 연결
| IN2 | 1번 아두이노 3번 핀에 연결
| IN3 | 2번 아두이노 2번 핀에 연결
| IN4 | 2번 아두이노 3번 핀에 연결
DHT11 | VCC | 아두이노 3.3V에 연결
| GND | 아두이노 GND에 연결
| S | 아두이노 6번 핀에 연결
물주기 모터 | GND | 트랜지스터와 연결
| VCC | 아두이노의 5V에 연결

※ 본문의 예시 내용을 지우고 과제 내용으로 변경하여 사용하세요

## 데이터 베이스 설계 (DATABASE)

## 전체데이터 구조

| 엔티티 관계도 - ERD

테이블 | 역할
cells | 재배 셀 정보
thresholds | 온도, 습도, 수액량 기준값
sensor_logs | ESP32에서 AWS로 들어온 센서 데이터
ai_readings | AI 분석 결과
approvals | 관리자 승인 요청 및 승인 결과
robot_tasks | AWS에서 Jetson Nano로 내려보낼 작업명령
robot_feedback | Jetson Nano가 AWS로 보내는 작업 진행 결과
system_events | 오류, 경고, ESTOP, 시스템 이벤트
system_settings | 시스템 설정값

## Slide 40

| 테이블 정의서 - ERD

컬럼 | 역할
id | 셀 데이터의 고유 번호입니다. 기본키(PK)로 사용됩니다.
cell_id | 실제 식물공장 내 셀 번호를 의미합니다. 예: 1번 셀 ~ 4번 셀
location | 해당 셀이 위치한 장소 또는 구역 정보입니다.
PLANT_ID | 해당 셀에 보식된 식물의 식별 ID입니다.
is_active | 셀 사용 여부를 나타냅니다. true이면 활성 셀, false이면 비활성 셀입니다.
CREATED_DATE | 셀 데이터가 처음 생성된 날짜와 시간입니다.
RE_PLANT_DATE | 식물이 보식된 날짜입니다. 성장률 계산 기준으로 사용할 수 있습니다.
GROWTH_RATE | 해당 셀 식물의 현재 성장률입니다.
AVG_growth_rate | 해당 셀의 평균 성장률입니다. 전체 생산성 계산에 활용됩니다.

## Slide 41

| 테이블 정의서 - ERD

컬럼 | 역할
id | 임계값 데이터의 고유 번호입니다. 기본키(PK)로 사용됩니다.
metric | 관리할 지표 이름입니다. ( temperature, humidity, disease_probability, sap_amount_ml)
min_value | 해당 지표의 최소 허용값입니다. 이 값보다 낮으면 이상 상태로 판단할 수 있습니다.
max_value | 해당 지표의 최대 허용값입니다. 이 값보다 높으면 경고 또는 위험 상태로 판단할 수 있습니다.
unit | 지표의 측정 단위입니다. 예: ℃, %, ml
enabled | 해당 임계값 사용 여부입니다. true이면 사용, false이면 미사용입니다.
description | 임계값에 대한 설명입니다. 어떤 기준값인지 관리자가 이해할 수 있도록 기록합니다.

## Slide 42

| 테이블 정의서 - ERD

컬럼 | 역할
id | 이벤트 로그의 고유 번호입니다. 기본키(PK)로 사용됩니다.
event_time | 이벤트가 발생한 날짜와 시간입니다.
event_type | 이벤트 종류입니다. 예: AI_MODE, ROBOT_REQUEST, ERROR, WARNING
cell_id | 특정 셀과 관련된 이벤트일 경우 해당 셀 번호를 저장합니다.
message | 이벤트 상세 내용입니다. 예: AI 모드 활성화, 로봇 오류 발생, 경고 알림 등

## Slide 43

| 테이블 정의서 - ERD

컬럼 | 역할
id | 이벤트 로그의 고유 번호입니다. 기본키(PK)로 사용됩니다.
event_time | 이벤트가 발생한 날짜와 시간입니다.
event_type | 이벤트 종류입니다. 예: AI_MODE, ROBOT_REQUEST, ERROR, WARNING
cell_id | 특정 셀과 관련된 이벤트일 경우 해당 셀 번호를 저장합니다.
message | 이벤트 상세 내용입니다. 예: AI 모드 활성화, 로봇 오류 발생, 경고 알림 등

## Slide 44

| 테이블 정의서 - ERD

컬럼 | 역할
id | AI 분석 결과의 고유 번호입니다. 기본키(PK)로 사용됩니다.
cell_id | AI 분석 대상이 된 식물 셀 번호입니다. cells 테이블과 연결됩니다.
sensor_log_id | AI 분석에 사용된 센서 로그 ID입니다. sensor_logs 테이블과 연결됩니다.
ai_mode | AI 판단 모드입니다. 예: NORMAL, OBSERVE, NUTRITION
detected_date | AI가 상태를 분석하거나 이상을 감지한 시간입니다.
disease_area | 이상이 감지된 식물 부위입니다. 예: LEAF, ROOT, STEM, FRUIT
disease_name | 감지된 문제 이름입니다. 예: NORMAL, growth_issue, 병해충명 등
disease_probability | 병해충 또는 성장 이상 발생 가능성을 수치로 나타낸 값입니다.
risk_level | AI가 판단한 위험도입니다. 예: NORMAL, WARNING, DANGER
recommended_task | AI 분석 결과에 따라 추천되는 작업입니다. 예: NONE, OBSERVE, NUTRITION

## Slide 45

| 테이블 정의서 - ERD

컬럼 | 역할
cell_id | 승인 요청이 발생한 식물 셀 번호입니다. cells 테이블과 연결됩니다.
id | 승인 요청의 고유 번호입니다. 기본키(PK)로 사용됩니다.
ai_reading_id | 승인 요청의 기준이 된 AI 분석 결과 ID입니다. ai_readings 테이블과 연결됩니다.
requested_at | 승인 요청이 생성된 시간입니다.
approval_status | 승인 상태입니다. 예: PENDING, APPROVED, REJECTED
approved_by | 승인 또는 거절을 처리한 관리자 정보입니다.
approved_at | 관리자가 승인 또는 거절을 처리한 시간입니다.

## Slide 46

| 테이블 정의서 - ERD

컬럼 | 역할
key | 설정 항목의 이름입니다. 기본키(PK)로 사용됩니다. 예: ai_mode, auto_monitor, system_status
value | 해당 설정 항목의 값입니다. 예: ON, OFF, AUTO_MONITOR, MANUAL
updated_at | 설정값이 마지막으로 변경된 시간입니다.

## Slide 47

| 테이블 정의서 - ERD

컬럼 | 역할
id | 로봇 피드백 데이터의 고유 번호입니다. 기본키(PK)로 사용됩니다.
task_id | 피드백이 연결된 로봇 작업 ID입니다. robot_tasks 테이블과 연결됩니다.
cell_id | 작업이 수행된 식물 셀 번호입니다. cells 테이블과 연결됩니다.
reported_at | 로봇이 피드백을 보고한 시간입니다.
progress_rate | 로봇 작업 진행률입니다. 0~100 범위로 표시됩니다.
temperature | 작업 중 측정된 셀 내부 온도값입니다.
humidity | 작업 중 측정된 셀 내부 습도값입니다.
sap_amount_ml | 작업 중 측정되거나 공급된 수액량입니다.
robot_status | 로봇의 현재 작업 상태입니다. 예: RUNNING, COMPLETE, ERROR

## Slide 48

| 테이블 정의서 - ERD

컬럼 | 역할
id | 로봇 작업의 고유 번호입니다. 기본키(PK)로 사용됩니다.
cell_id | 작업 대상 식물 셀 번호입니다. cells 테이블과 연결됩니다.
approval_id | 해당 작업을 승인한 관리자 승인 요청 ID입니다. approvals 테이블과 연결됩니다.
task_name | 로봇이 수행할 작업 이름입니다. 예: OBSERVE, NUTRITION, ESTOP
control_state | 로봇 제어 상태입니다. 예: RUN, STOP, ESTOP
state_machine | 로봇 작업의 현재 처리 단계입니다. 예: AI_DETECT, WAIT_APPROVAL, EXECUTE_TASK, REPORT_STATUS, COMPLETE
progress_rate | 작업 진행률입니다. 0~100 범위로 작업 완료 정도를 표시합니다.
robot_status | 로봇의 현재 상태 메시지입니다. 예: WAITING, COMMAND_SENT, RUNNING, COMPLETE, ERROR
command_payload | 로봇에게 전달할 상세 명령 데이터입니다. 이동 위치, 작업 파라미터 등을 저장할 수 있습니다.
created_at | 로봇 작업이 생성된 시간입니다.
started_at | 로봇 작업이 실제로 시작된 시간입니다.
completed_at | 로봇 작업이 완료된 시간입니다.

## Slide 49

| 엔티티 관계도 - ERD

테이블 간 관계(외래키 관계)

## 소프트웨어기능 설계 (Software funtion design)

## Slide 51

| 프로그램 - 목록

기능 분류 | 기능파일 | 기능 명
JETSON_ROBOT | strew_robot/main.py | 실행 진입점
| agent.py | 전체 작업 흐름 제어
| cloud_client.py | AWS API 통신
| vision_source.py | CSI 카메라/Mock 비전 소스
| arduino_link.py | USB 시리얼 JSON 통신
| strew-robot-agent.service | Jetson 부팅 후 python -m strew_robot.main 자동 실행 가능하도록 서비스 파일 제공.
AWS _SERVER | app\main.py | /robot/request: 로봇에게 보낼 작업 생성 /robot/next: 특정 로봇이 다음 작업을 가져감 /robot/response: 로봇 수행 결과 저장 /vision/event: Jetson/카메라 비전 이벤트 저장 /robot/tasks, /robot/responses: 작업/응답 목록 조회 /health: 상태 확인 /: 간단한 웹 대시보드 제공
| a (http://schemas.py/)pp\ (http://schemas.py/)schemas.py | API 데이터 구조 정의 RobotTask, RobotResponse, VisionEvent 작업 상태: queued, sent, running, done, failed, cancelled
| app\repository.py | 저장소 계층 로컬 개발 시 data/strew_store.json에 저장 AWS 배포 시 DynamoDB에 저장 즉, 같은 API를 로컬/클라우드 둘 다에서 쓸 수 있게 만든 구조입니다.

## Slide 52

| 프로그램 - 목록

기능 분류 | 기능파일 | 기능 명
AWS_SERVER | app\settings.py | .env 기반 설정 저장소 선택: local 또는 dynamodb AWS 리전, DynamoDB 테이블명, API 키 설정
| terraform\main.tf | AWS 인프라 정의 VPC, Public Subnet, Internet Gateway Application Load Balancer ECS Fargate 서비스 DynamoDB 테이블 CloudWatch Log Group ECS Task Role/IAM 권한 배포 시 STORAGE_BACKEND=dynamodb로 실행되게 구성
| terraform\variables.tf | project_name aws_region container_image api_key
| scripts\run_local.ps1 | 로컬 개발 실행 스크립트 .env 생성, venv 생성, requirements 설치, uvicorn 실행 scripts\build_and_push_ecr.ps1
| scripts\build_and_push_ecr.ps1 | Docker 이미지 빌드 AWS ECR 로그인 이미지 태그 후 ECR에 push
| app\static\index.html | 간단한 웹 화면 API Key 입력 후 로봇 작업 전송 최근 작업 목록 조회

## Slide 53

| 알고리즘 명세서

구분 | 기능 | 설명
S/W | 하우스 식물 온도습도 상태보기 | 최근 일주일 동안 누적된 식물의 온도 습도 데이터를 그래프화하여 확인할 수 있습니다.
| 식물셀 상시 모니터링 | 4개 셀에 보식된 식물의 상태를 지속적으로 감시하고 병해충 발생 여부를 확인합니다.
| AI 드라이브 자동 판단 | 설정된 임계값을 초과하면 AI가 자동으로 상태를 분석하고 위험 여부를 판단합니다.
| 보식 작업 결정 | AI 분석 결과를 바탕으로 문제가 발생한 식물셀의 보식 필요 여부를 결정합니다.
| 성장률 및 생산성 분석 | 보식 날짜를 기준으로 셀별 평균 성장률을 계산하고 전체 생산성을 산출합니다.
| 생장 환경 최적화 제어 | 온습도 측정값을 목표 설정값과 비교하고 PID 제어를 통해 생장 환경을 최적화합니다.

## Slide 54

| 알고리즘 상세 설명서

1. 시스템 시작 및 셀 조회
시스템이 시작되면 cells 테이블에서 활성화된 식물 셀 목록을 조회한다.
조회 대상은 기본적으로 1번부터 4번까지의 셀이며, is_active 값이 활성 상태인 셀만 검사 대상으로 지정한다.

사용 테이블
- cells
처리 내용
active_cells = cells where is_active = true

## Slide 55

| 알고리즘 상세 설명서

2. 셀별 센서 데이터 수집
시스템은 조회된 셀을 순서대로 검사한다.
각 셀에 대해 온도, 습도, 수액량 등의 센서 데이터를 측정한다.

수집 데이터
- 셀 번호
- 온도
- 습도
- 수액량
- 측정 시간

## Slide 56

| 알고리즘 상세 설명서

3. 센서 로그 저장
측정된 센서값은 sensor_logs 테이블에 저장한다.
이 데이터는 이후 임계값 비교와 AI 분석의 기준 데이터로 사용된다.

사용 테이블
- sensor_logs
저장 항목
measured_at
temperature
humidity
sap_amount_ml
env_warning

## Slide 57

| 알고리즘 상세 설명서

4. 임계값 조회 및 정상 범위 판단
시스템은 thresholds 테이블에서 관리자가 설정한 기준값을 조회한다.
온도, 습도, 수액량, 병해충 확률 등의 항목을 기준으로 현재 센서값이 정상 범위에 있는지 판단한다.

사용 테이블
- Thresholds
판단 로직
if sensor_value < min_value or sensor_value > max_value:
status = WARNING
else:
status = NORMAL

## Slide 58

| 알고리즘 상세 설명서

5. 환경 경고 및 이벤트 기록
센서값이 임계값을 벗어나면 해당 센서 로그의 env_warning 값을 WARNING으로 처리한다.
또한 이상 상태 발생 내용을 system_events 테이블에 이벤트로 저장한다.

사용 테이블
- sensor_logs
- system_events
처리 내용
env_warning = WARNING
save system_events

## Slide 59

| 알고리즘 상세 설명서

6. AI 분석 실행
AI 드라이브 모드가 활성화되어 있으면 센서값, 임계값 초과 여부, 식물 상태 데이터를 기반으로 AI 분석을 실행한다.
AI는 식물의 병해충 가능성, 이상 부위, 위험도, 추천 작업을 판단한다.

분석 기준
- 온도
- 습도
- 수액량
- 성장률
- 병해충 가능성
- 임계값 초과 여부
- 셀 상태

## Slide 60

| 알고리즘 상세 설명서

7. AI 분석 결과 저장
AI 분석 결과는 ai_readings 테이블에 저장한다.
각 결과는 특정 셀과 센서 로그에 연결된다.

ai_readings

cell_id

sensor_log_id

ai_mode

detected_date

disease_area

disease_name

disease_probability

risk_level

recommended_task

## Slide 61

| 알고리즘 상세 설명서

8. 위험도 판단
AI는 각 셀의 상태를 risk_level 기준으로 분류한다.

위험도 | 처리 내용
NORMAL | 정상 상태로 판단하고 작업을 생성하지 않음
WARNING | 관찰 작업이 필요하다고 판단
DANGER | 영양 공급 또는 보식 등 즉시 조치가 필요하다고 판단

## Slide 62

| 알고리즘 상세 설명서

9. 추천 작업 결정
위험도에 따라 추천 작업을 결정한다.

처리 로직
if risk_level = NORMAL:
recommended_task = NONE
if risk_level = WARNING:
recommended_task = OBSERVE
if risk_level = DANGER:
recommended_task = NUTRITION
NORMAL 상태이면 별도 작업 없이 다음 셀 검사 단계로 이동한다.
WARNING 또는 DANGER 상태이면 관리자 승인 요청을 생성한다.

## Slide 63

| 알고리즘 상세 설명서

10. 관리자 승인 요청 생성
AI가 작업을 추천한 경우 approvals 테이블에 승인 요청을 생성한다.
추천 작업은 즉시 실행되지 않고, PENDING 상태로 관리자 검토를 기다린다.

사용 테이블
- Approvals
저장 항목
cell_id
ai_reading_id
requested_at
approval_status = PENDING

## Slide 64

| 알고리즘 상세 설명서

11. 관리자 승인 결과 처리
관리자는 AI 추천 작업을 승인하거나 거절할 수 있다.
승인 시
승인 상태를 APPROVED로 저장하고, 로봇 작업을 생성한다.
승인 거절 시
승인 상태를 REJECTED로 저장하고, system_events에 거절 이벤트를 기록한다.
이후 해당 셀의 작업은 종료되고 다음 셀 검사로 이동한다.

- 사용 테이블
- system_events
- approvals

## Slide 65

| 알고리즘 상세 설명서

12. 로봇 작업 생성
관리자가 승인한 작업은 robot_tasks 테이블에 저장된다.
작업명은 AI 추천 결과에 따라 OBSERVE 또는 NUTRITION으로 설정된다.

사용 테이블
- robot_tasks

저장 항목
cell_id
approval_id
task_name
control_state
state_machine
progress_rate
robot_status
command_payload
created_at

## Slide 66

| 알고리즘 상세 설명서

13. 로봇 작업 수행
로봇은 생성된 작업 명령을 기준으로 대상 셀로 이동하여 작업을 수행한다.
작업 종류에 따라 관찰, 영양 공급, 보식 관련 동작을 실행한다.

작업 예시
- OBSERVE: 셀 상태 재촬영 및 재측정
- NUTRITION: 영양 공급 또는 생장 보조 작업
- ESTOP: 비상 정지

## Slide 67

| 알고리즘 상세 설명서

14. 로봇 피드백 저장
로봇 작업 중 발생하는 진행률, 상태, 센서값은 robot_feedback 테이블에 저장한다.
작업이 진행 중이면 progress_rate를 갱신하고, 작업 상태를 지속적으로 기록한다.

사용 테이블
- robot_feedback

저장 항목
task_id
cell_id
reported_at
progress_rate
temperature
humidity
sap_amount_ml
robot_status

## Slide 68

| 알고리즘 상세 설명서

15. 작업 완료 처리
로봇 작업이 완료되면 robot_tasks의 상태를 완료 단계로 변경하고, 완료 시간을 저장한다.
필요 시 system_events에 작업 완료 이벤트를 기록한다.

사용 테이블
- robot_tasks
- system_events
처리 내용
state_machine = COMPLETE
progress_rate = 100
completed_at = current_time
save system_events

## Slide 69

| 알고리즘 상세 설명서

16. 다음 측정 주기 반복
현재 셀의 처리가 완료되면 다음 셀을 검사한다.
1번부터 4번까지 모든 셀의 순회가 완료되면 전체 상태를 저장하고, 다음 측정 주기까지 대기한다.

처리 내용
if next_cell exists:
move to next cell
else:
wait until next monitoring cycle

## 사용자 인터페이스 설계 (User Interface design)

## Slide 71

| 화면 설계서 – 전체 메인 프로그램

이 디스플레이는 식물공장 내부 환경과 셀 상태를 한눈에 확인할 수 있는 요약 대시보드입니다.
관리자는 이를 통해 전체 식물공장의 운영 상태와 이상 여부를 빠르게 파악할 수 있습니다.

## Slide 72

화면 설계서 – 사용자 인터페이스

주요기능설명

1.실시간 온습도 모니터링
각 식물 셀의 온도와 습도 변화를 그래프로 확인합니다.

2.우선순위 관리
위험도가 높은 셀을 자동 정렬하거나 상단에 고정할 수 있습니다. 현재 화면에서는 셀 3이 가장 높은 우선 점검 대상입니다.

## Slide 73

| 화면 설계서 - 사용자 인터페이스

3. 각 실물 셀 인터페이스 기능
각 셀 카드는 개별 재배 구역의 상태를 한눈에 확인하는 단위 UI입니다.

4.현재 운영 중인 셀 수, 경고 발생 수, 보류 중인 작업, 평균 온도, 시스템 리스크를 실시간으로 표시합니다.

## Slide 74

| 화면 설계서 - 사용자 인터페이스

5.AI 모드 ON/OFF 기능은 관리자가 AI 자동 판단 사용 여부를 선택하는 기능입니다.
AI 모드 ON
센서값이 임계값을 초과하면 AI가 자동으로 상태를 분석하고, 위험도와 추천 작업을 판단합니다.
AI 모드 OFF
AI 자동 판단을 사용하지 않고, 관리자가 직접 셀 상태를 확인해 작업 여부를 결정합니다.

## Slide 75

| 메뉴 구성도 관리자 페이지

이 디스플레이는 식물공장 내부 환경과 셀 상태를 한눈에 확인할 수 있는 요약 대시보드입니다.

## Slide 76

| 메뉴 구성도 관리자 페이지

DB 기반 운영 데이터 관리 탭

탭 | 기능 설명
Sensor | 온도, 습도, 수액량 등 셀별 실시간 센서값을 확인합니다.
AI | AI가 분석한 위험도, 병해충 가능성, 추천 작업 결과를 확인합니다.
Robot Tasks | 로봇이 수행 중이거나 대기 중인 작업 상태를 확인합니다.
Feedback | 로봇 작업 결과와 AI 재학습에 활용되는 피드백 데이터를 확인합니다.
Events | AI 모드 변경, 로봇 작업 요청, 오류 발생, 관리자 조작 등 주요 운영 이벤트를 시간순으로 기록합니다.
Thresholds | 온도, 습도, 병해충 확률, 수액량 등의 임계값을 설정하고 관리합니다.

이 관리자 페이지는 식물공장 내에서 발생하는 모든 운영 데이터를 DB에서 불러와 통합 관리하는 화면입니다.
관리자는 각 탭을 통해 셀별 상태, 환경 데이터, AI 판단 결과, 로봇 작업 현황, 이벤트 발생 이력, 임계값 설정 정보를 한눈에 확인하고 관리할 수 있습니다.
이를 통해 식물공장의 이상 상태를 빠르게 감지하고, 필요한 작업을 즉시 판단하여 안정적인 생장 환경과 운영 효율을 유지할 수 있습니다.

## Slide 77

| 메뉴 구성도 관리자 페이지

온도, 습도, 수액량 등 셀별 실시간 센서값을 확인합니다.

id | 센서 로그의 고유 번호입니다.
cell_name | 측정 대상 셀 이름입니다. 예: Cell 1 ~ Cell 4
measured_at | 센서값이 측정된 시간입니다.
temperature | 해당 셀의 온도 측정값입니다.
humidity | 해당 셀의 습도 측정값입니다.
sap_amount_ml | 식물에 공급되거나 측정된 수액량입니다.
growth_rate | 해당 셀 식물의 성장률입니다.
env_warning | 환경 상태 판단 결과입니다. NORMAL이면 정상 상태를 의미합니다.

## Slide 78

| 메뉴 구성도 관리자 페이지

AI가 분석한 위험도, 병해충 가능성, 추천 작업 결과를 확인합니다.

id | AI 분석 결과의 고유 번호입니다.
cell_name | AI가 분석한 대상 셀 이름입니다. 예: Cell 1 ~ Cell 4
detected_at | AI 분석이 수행되거나 이상 상태가 감지된 시간입니다.
ai_mode | AI가 판단한 관리 모드입니다. 예: 관찰 OBSERVE, 영양 공급 NUTRITION
disease_area | 이상이 감지된 식물 부위입니다. 예: 잎, 뿌리, 줄기, 열매
disease_name | 감지된 문제 유형입니다. 예: 정상 NORMAL, 성장 문제 growth_issue
disease_probability | 병해충 또는 성장 이상 발생 가능성을 수치로 나타낸 값입니다.
risk_level | AI가 판단한 위험도입니다. 예: NORMAL, WARNING, DANGER
recommended_task | AI 분석 결과에 따라 추천되는 작업입니다. 예: 없음 NONE, 영양 공급 NUTRITION, 관찰 OBSERVE

## Slide 79

| 메뉴 구성도 관리자 페이지

로봇이 수행 중이거나 대기 중인 작업 상태를 확인합니다.

id | 로봇 작업의 고유 번호입니다.
cell_name | 작업 대상 셀 이름입니다.
task_name | 로봇이 수행할 작업 종류입니다. 예: NUTRITION
control_state | 작업 제어 상태입니다. 예: RUN이면 작업 실행 상태를 의미합니다.
state_machine | 로봇 작업의 현재 처리 단계입니다. 예: EXECUTE_TASK
progress_rate | 작업 진행률입니다. 0부터 100까지의 값으로 표시할 수 있습니다.
robot_status | 로봇 명령 전송 및 처리 상태입니다. 예: COMMAND_SENT, SENT_TO_ROBOT
created_at | 로봇 작업이 생성된 시간입니다.

## Slide 80

| 메뉴 구성도 관리자 페이지

시스템 이벤트 발생 이력을 확인하는 화면입니다.

항목 | 역할 설명
id | 이벤트 로그의 고유 번호입니다.
event_time | 이벤트가 발생한 시간입니다.
event_type | 이벤트 종류입니다. 예: AI_MODE, ROBOT_REQUEST
cell_id | 이벤트가 특정 셀과 관련된 경우 해당 셀 번호를 표시합니다.
message | 이벤트 상세 내용입니다. 예: AI 모드 활성화, 비활성화, 로봇 작업 요청 등

## Slide 81

| 메뉴 구성도 관리자 페이지

온도, 습도, 병해충 확률, 수액량 등의 임계값을 설정하고 관리합니다.

**관리항목
1.disease_probability - 식물의 질병 발생 가능성
2.humidity - 셀 내부 습도
3.sap_amount_ml - 식물 또는 셀에 공급되수액/양액량
4.temperature - 셀 내부 온도

관리자는 UI에서 임계값 설정 기능을 통해 식물 관리 기준을 직접 조정할 수 있습니다.
각 항목별로 최소값, 최대값, 단위, 사용 여부를 설정할 수 있으며,
설정된 기준을 바탕으로 시스템이 실시간 데이터를 분석합니다.
설정값을 초과하거나 기준을 벗어나면 AI 분석 및 알림 기능과 연동되어,
관리자가 빠르게 이상 상태를 확인하고 대응할 수 있습니다.

## Slide 82

메뉴 구성도 - 관리자 검토

문제 셀, AI 위험도, 관리자 승인 대기 항목을 한 화면에서 검토합니다

식물셀에서 위험 상태가 감지되면 AI 판단 결과를 기반으로 관리자에게 보식 작업 승인 알림을 제공합니다.

## Slide 83

메뉴 구성도 - 관리자 검토

위험 보식 승인 알림 기능은 AI가 특정 식물셀에서 위험 상태를 감지했을 때, 관리자에게 보식 작업 승인 여부를 요청하는 기능입니다.
AI가 병해충 또는 성장 이상 가능성을 분석해 DANGER 상태로 판단하면, 해당 셀의 정보와 추천 작업이 알림 카드로 표시됩니다.
관리자는 알림을 확인한 뒤 보식 또는 영양 공급 작업을 승인하거나 검토 완료 처리할 수 있습니다.

## 프로잭트 참조 및 관리

## Slide 85

| 참조-동영상 촬영 콘티

## Slide 86

| 참조-프로젝트 관리

Google Drive를 활용해 리소스를 공유하고, 설계 파일과 도면을 통합 관리합니다.

https://drive.google.com/drive/folders/1I0clueM3rRFAS95cF1BC3ihl6Df4eD0n

## Slide 87

| 참조-프로젝트 관리

Notion을 활용해 전체 회의 문서와 파트별 문서를 체계적으로 관리합니다.

https://www.notion.so/STREW_VISION-359df5ba9e0280d39fc7eae4bca2d8a8?source=copy_link

## Slide 88

| 참조-프로젝트 관리

GitHub을 활용해 서버 프로그램 코드 작성, 업데이트, 버전 관리를 체계적으로 수행합니다.

https://github.com/Leechanyeop/STREW_VISION

## Slide 89

Thank you
