Leechanyeop/STREW-VISION/strew-hardware/BOM/STREW-VISION_3DPrinting_BOM.xlsx

STREW-VISION 3D Printing BOM (Bill of Materials)
출처: C:\STREW_VISION\strew-hardware\3D Printing (STL 형상 분석 기준, 2026-07-02)
재질 밀도 가정 (Material Density) | 1.24 | g/cm³ (PLA 기준, 파란색 셀 값 변경 시 중량 자동 재계산)
No | Part No | Part Name | 원본 파일명 | 수량 (EA) | X (mm) | Y (mm) | Z (mm) | 단위 부피 (cm³) | 수량 부피 (cm³) | 단위 예상중량 (g) | 총 예상중량 (g) | 비고 | 실물
1 | 1-BFP-00 | Belt fixing plate | (1EA)1-BFP-00_Belt fixing plate.stl | 1 | 4 | 18 | 84 | 3.27 | 3.27 | 4.05 | 4.05
2 | 1-BP-00 | Bord Plate | (1EA)1-BP-00_Bord Plate.stl | 1 | 34 | 113 | 110 | 42.27 | 42.27 | 52.41 | 52.41
3 | 1-BP-01 | Base Plate | (1EA)1-BP-01_Base Plate.stl | 1 | 128 | 25.5 | 84 | 113.4 | 113.40 | 140.62 | 140.62
4 | 1-CCB-00 | Cable Chain Bracket | (1EA)1-CCB-00_Cable Chain Bracket.stl | 1 | 34 | 22 | 76 | 20.75 | 20.75 | 25.73 | 25.73
5 | 1-DjbB-00 | Dual Joint Box Base | (1EA)1-DjbB-00_Dual Joint Box Base.stl | 1 | 216 | 28 | 170 | 330.77 | 330.77 | 410.15 | 410.15
6 | 1-IB-00 | Idler Block | (1EA)1-IB-00_Idler Block.stl | 1 | 50 | 10 | 30 | 13.31 | 13.31 | 16.50 | 16.50 | 리비전 00 (1-IB-01과 형상 상이, 사용처 확인 필요)
7 | 1-IB-01 | Idler Block | (1EA)1-IB-01_Idler Block.stl | 1 | 50 | 18 | 30 | 13.84 | 13.84 | 17.16 | 17.16 | 리비전 01 (1-IB-00과 형상 상이, 사용처 확인 필요)
8 | 1-JBC-01 | Joint Box Cover | (1EA)1-JBC-01_Joint Box Cover.stl | 1 | 60 | 90 | 7 | 11.01 | 11.01 | 13.65 | 13.65 | 리비전 01 (1-JBC-00과 치수 상이)
9 | 1-MB-00 | Motor Block | (1EA)1-MB-00__Motor Block.stl | 1 | 62 | 10 | 42 | 20.37 | 20.37 | 25.26 | 25.26 | 리비전 00
10 | 1-MB-01 | Motor Block | (1EA)1-MB-01__Motor Block.stl | 1 | 62 | 18 | 30 | 15.23 | 15.23 | 18.89 | 18.89 | 리비전 01
11 | 1-PC-00 | Pi Camera | (1EA)1-PC-00_Pi Camera.stl | 1 | 25 | 17.5 | 12.5 | 2.87 | 2.87 | 3.56 | 3.56
12 | 1-SA-01 | Servo Arm | (1EA)1-SA-01_Servo Arm.stl | 1 | 30 | 54.9 | 15.5 | 16.04 | 16.04 | 19.89 | 19.89 | 리비전 01
13 | 1-SA-02 | Servo Arm | (1EA)1-SA-02_Servo Arm.stl | 1 | 30 | 54.9 | 19 | 16.31 | 16.31 | 20.22 | 20.22 | 리비전 02
14 | 1-SDL-00 | Sensor Disk Limit | (1EA)1-SDL-00_Sensor Disk Limit.stl | 1 | 10 | 33 | 9 | 1.97 | 1.97 | 2.44 | 2.44
15 | 1-SRB-00 | Servo rotary Base | (1EA)1-SRB-00_Servo rotary Base.stl | 1 | 225 | 58 | 169.9 | 637.43 | 637.43 | 790.41 | 790.41
16 | 1-SRP-00 | Servo rotary plate | (1EA)1-SRP-00_Servo rotary plate.stl | 1 | 30 | 15 | 52 | 15.52 | 15.52 | 19.24 | 19.24
17 | GRIPPER-5 | Gripper (Type 5) | (1EA)Gripper_5.stl | 1 | 70 | 64.5 | 120 | 96.21 | 96.21 | 119.30 | 119.30 | 정식 파트넘버 없음 - 파일명 기준 임시 부여
18 | GEAR-1 | Spur Gear 1 | (1EA)Spur gear1.stl | 1 | 34 | 63.9 | 11 | 11.07 | 11.07 | 13.73 | 13.73 | 정식 파트넘버 없음 - 파일명 기준 임시 부여
19 | GEAR-2 | Spur Gear 2 | (1EA)Spur gear2.stl | 1 | 34 | 63.1 | 10 | 10.73 | 10.73 | 13.31 | 13.31 | 정식 파트넘버 없음 - 파일명 기준 임시 부여
20 | BALL-PI16 | Ball Joint (Dia.16) | (26EA)Ball_Pi16.stl | 26 | 16.1 | 16.1 | 16.2 | 2.2 | 57.20 | 2.73 | 70.93 | 구형 조인트 볼로 추정
21 | 1-DJB-00 | Dual Joint Box | (2EA)1-DJB-00_Dual Joint Box.stl | 2 | 60 | 98 | 32 | 50.78 | 101.56 | 62.97 | 125.93
22 | 1-HC-00 | handle cover | (2EA)1-HC-00_handle cover.stl | 2 | 120 | 30 | 40 | 17.45 | 34.90 | 21.64 | 43.28
23 | GRIPPER-4 | Gripper (Type 4) | (2EA)Gripper_4.stl | 2 | 100 | 15 | 19 | 20.17 | 40.34 | 25.01 | 50.02 | 정식 파트넘버 없음 - 파일명 기준 임시 부여
24 | 1-IA-00 | Idler Arm | (4EA)1-IA-00_Idler Arm.stl | 4 | 30 | 54.9 | 17 | 14.49 | 57.96 | 17.97 | 71.87
25 | 1-JB-00 | Joint Box | (4EA)1-JB-00_Joint Box.stl | 4 | 60 | 98 | 32 | 45.5 | 182.00 | 56.42 | 225.68
26 | 1-SA-00 | Servo Arm | (4EA)1-SA-00_Servo Arm.stl | 4 | 30 | 55 | 13 | 15.58 | 62.32 | 19.32 | 77.28 | 리비전 00
27 | GRIPPER-3 | Gripper (Type 3) | (4EA)Gripper_3.stl | 4 | 53.9 | 10 | 14 | 6.08 | 24.32 | 7.54 | 30.16 | 정식 파트넘버 없음 - 파일명 기준 임시 부여
28 | 1-JBC-00 | Joint Box Cover | (5EA)1-JBC-00_Joint Box Cover.stl | 5 | 60 | 90 | 2 | 10.67 | 53.35 | 13.23 | 66.15 | 리비전 00 (1-JBC-01과 치수 상이)
29 | FLOWERPOT-1 | Flowerpot 1 (사본) | (5EA)Flowerpot_1 (2).stl | 5 | 50.8 | 50 | 42.8 | 21.85 | 109.25 | 27.09 | 135.47 | 'Flowerpot_1.stl'과 치수/부피 동일 - 파일 중복 여부 확인 필요
30 | FLOWERPOT-1 | Flowerpot 1 | (5EA)Flowerpot_1.stl | 5 | 50.8 | 50 | 42.8 | 21.85 | 109.25 | 27.09 | 135.47 | 'Flowerpot_1 (2).stl'과 치수/부피 동일 - 파일 중복 여부 확인 필요
31 | 1-SB-00 | Sensor Bracket | (7EA)1-SB-00_Sensor Bracket.stl | 7 | 12 | 24 | 9 | 1.26 | 8.82 | 1.56 | 10.94
합계 |  |  |  | 89 |  |  |  |  | 2233.64 |  | 2769.71
고유 파트 종류 수 |  |  |  | 31
참고 사항:
1) 부피는 각 STL 메쉬의 바운딩 형상을 기준으로 산출한 설계상(솔리드 100%) 부피이며, 실제 FDM 출력 중량은 인필(Infill) 비율·쉘 두께에 따라 이보다 작습니다. 위 '예상중량'은 100% 솔리드 기준 상한값입니다.
2) 'Idler Block'(00/01), 'Servo Arm'(00/01/02), 'Joint Box Cover'(00/01)는 리비전(개정) 넘버가 다른 유사 형상으로, 실제 조립 도면상 사용처를 확인해야 합니다.
3) 'Flowerpot_1.stl'과 'Flowerpot_1 (2).stl'은 치수·부피가 완전히 동일하여 파일 중복 저장 가능성이 있습니다.
4) Gripper, Spur Gear, Ball 항목은 CAD 도면상 정식 파트넘버가 부여되어 있지 않아 파일명 기준으로 임시 코드를 부여했습니다.
5) 재질 밀도(B4 셀)를 실제 사용 필라멘트에 맞게 변경하면 중량 열이 자동으로 재계산됩니다.
