Leechanyeop/STREW-VISION/strew-hardware/3D Printing/(1EA)1-PC-00_Pi Camera.stl

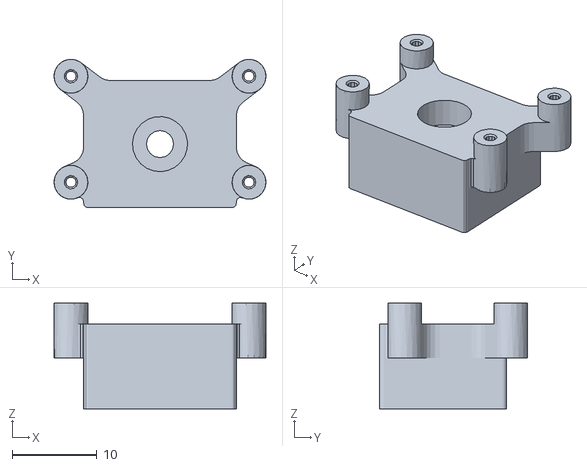
[picture p2: CAD file, 2026-07-07]
strew-hardware/3D Printing/(1EA)1-PC-00_Pi Camera.stl
25.0 x 17.5 x 12.5
