Leechanyeop/STREW-VISION/strew-hardware/CAD/카카오톡 받은 파일/(1EA)1-SRP-00_Servo rotary plate_0719.stl

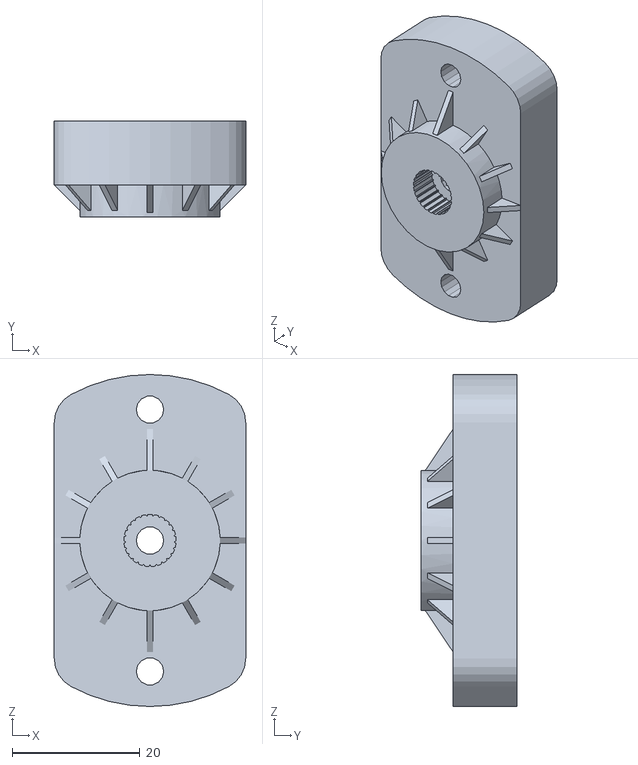
[picture p3: CAD file, 2026-08-02]
strew-hardware/CAD/카카오톡 받은 파일/(1EA)1-SRP-00_Servo rotary plate_0719.stl
30.0 x 15.0 x 52.0
