Leechanyeop/STREW-VISION/strew-hardware/3D Printing/(1EA)1-JBC-01_Joint Box Cover.stl

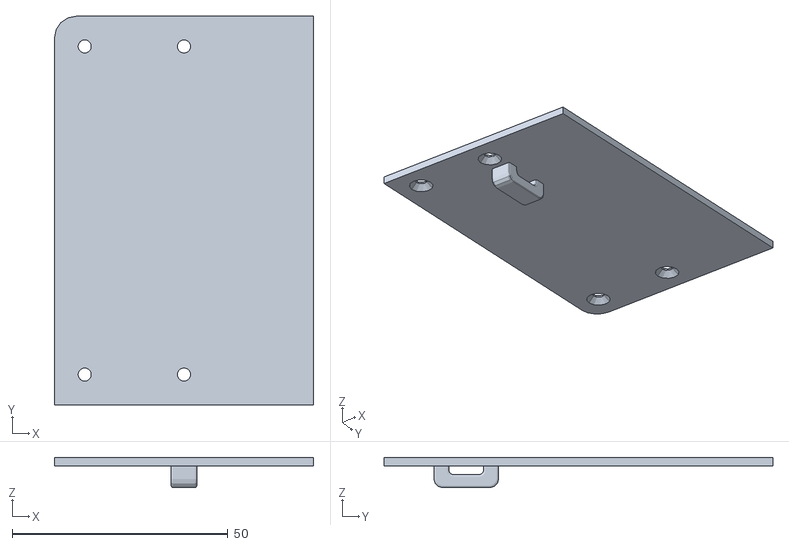
[picture p4: CAD file, 2026-07-07]
strew-hardware/3D Printing/(1EA)1-JBC-01_Joint Box Cover.stl
60.0 x 90.0 x 7.00
