Leechanyeop/STREW-VISION/strew-hardware/CAD/카카오톡 받은 파일/first(4EA)_E-CLBPS6-9-3_0719.stl

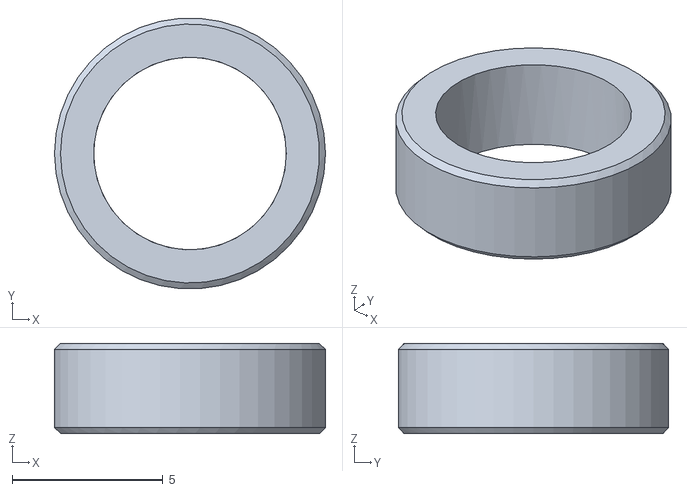
[picture p5: CAD file, 2026-08-02]
strew-hardware/CAD/카카오톡 받은 파일/first(4EA)_E-CLBPS6-9-3_0719.stl
9.00 x 8.97 x 3.00
