Leechanyeop/STREW-VISION/strew-hardware/CAD/카카오톡 받은 파일/0727(4EA)_1-SA-03_Servo Arm.stl

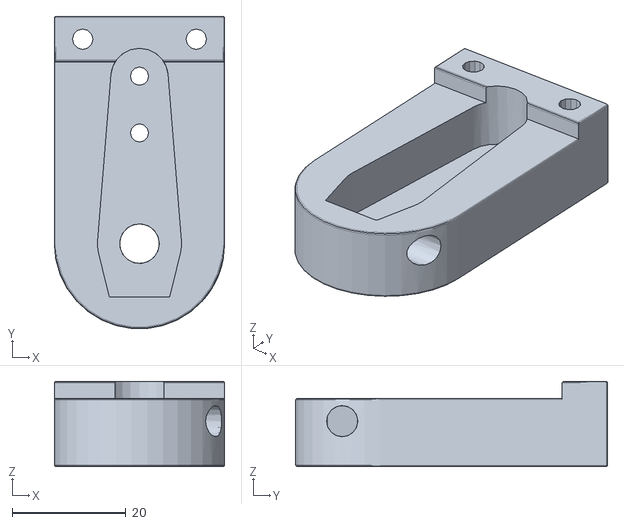
[picture p6: CAD file, 2026-08-02]
strew-hardware/CAD/카카오톡 받은 파일/0727(4EA)_1-SA-03_Servo Arm.stl
30.0 x 54.9 x 15.0
