Leechanyeop/STREW-VISION/strew-hardware/3D Printing/(4EA)1-IA-00_Idler Arm.stl

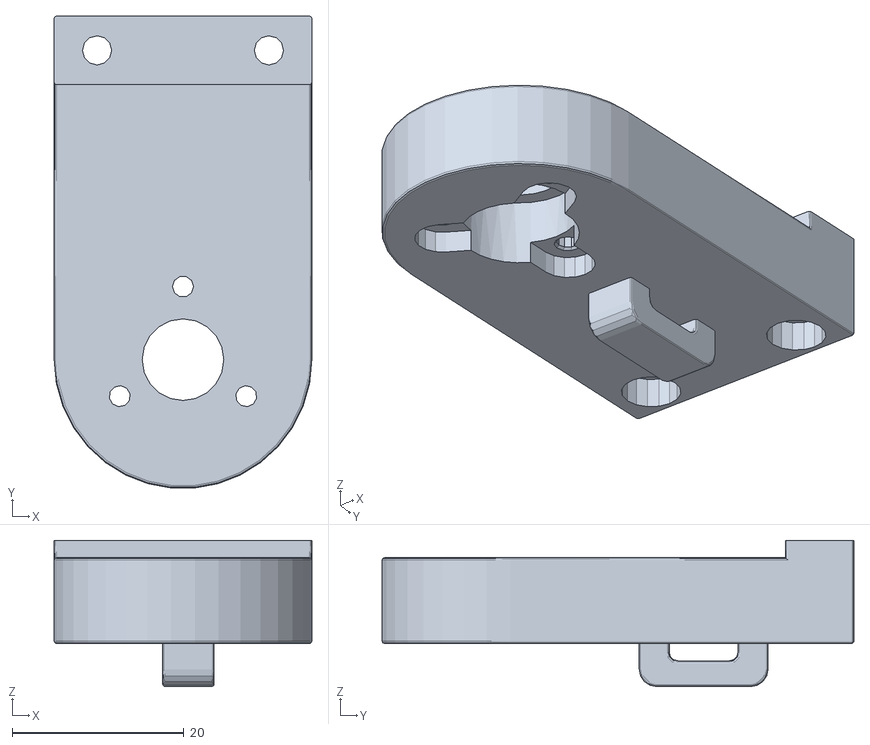
[picture p7: CAD file, 2026-07-07]
strew-hardware/3D Printing/(4EA)1-IA-00_Idler Arm.stl
30.0 x 54.9 x 17.0
