Leechanyeop/STREW-VISION/strew-hardware/CAD/카카오톡 받은 파일/0727(1EA)_1-SA-05_Servo Arm.stl

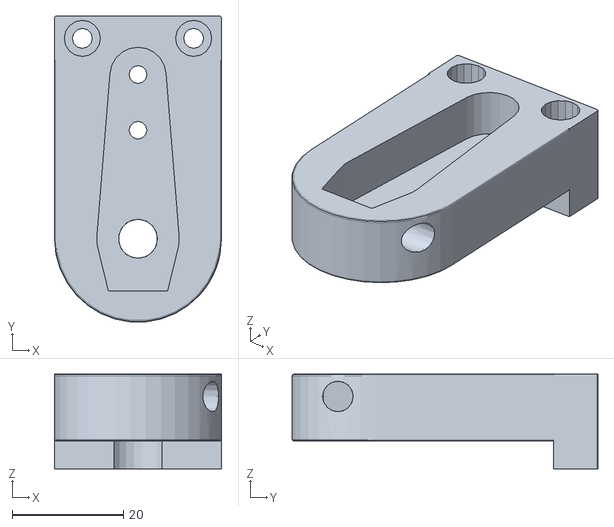
[picture p8: CAD file, 2026-08-02]
strew-hardware/CAD/카카오톡 받은 파일/0727(1EA)_1-SA-05_Servo Arm.stl
30.0 x 54.9 x 17.0
