Leechanyeop/STREW-VISION/strew-hardware/3D Printing/(4EA)1-JB-00_Joint Box.stl

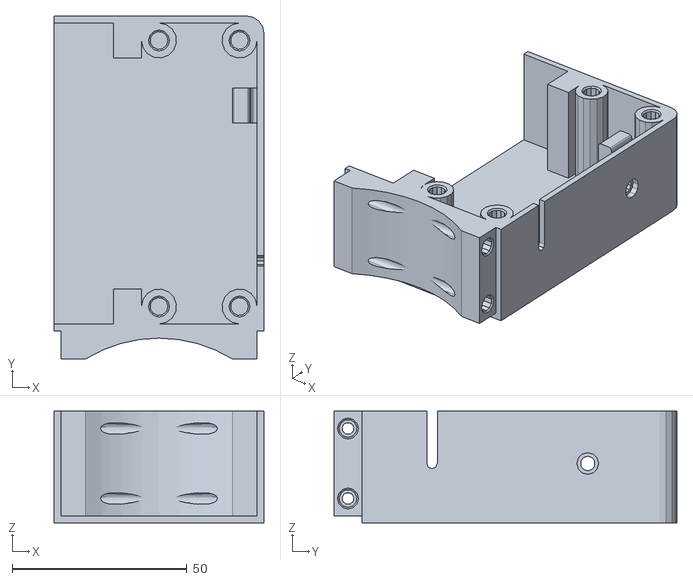
[picture p9: CAD file, 2026-07-07]
strew-hardware/3D Printing/(4EA)1-JB-00_Joint Box.stl
60.0 x 98.0 x 32.0
