Leechanyeop/STREW-VISION/strew-hardware/3D Printing/(1EA)1-IB-01_Idler Block.stl

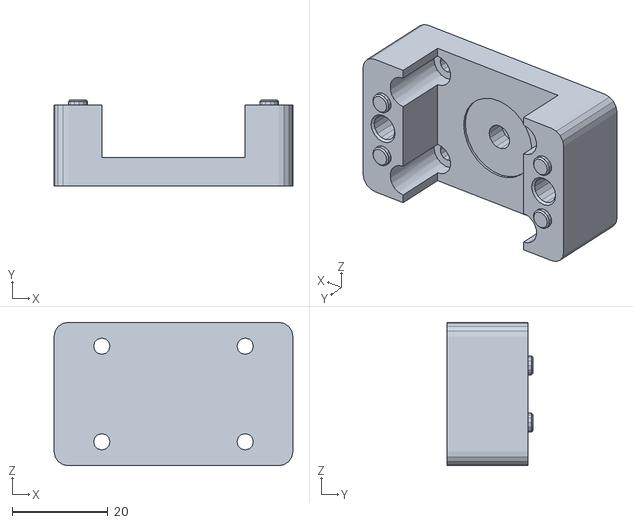
[picture p11: CAD file, 2026-07-07]
strew-hardware/3D Printing/(1EA)1-IB-01_Idler Block.stl
50.0 x 18.0 x 30.0
