Leechanyeop/STREW-VISION/strew-hardware/CAD/카카오톡 받은 파일/(1EA)_Spur gear11_0719.stl

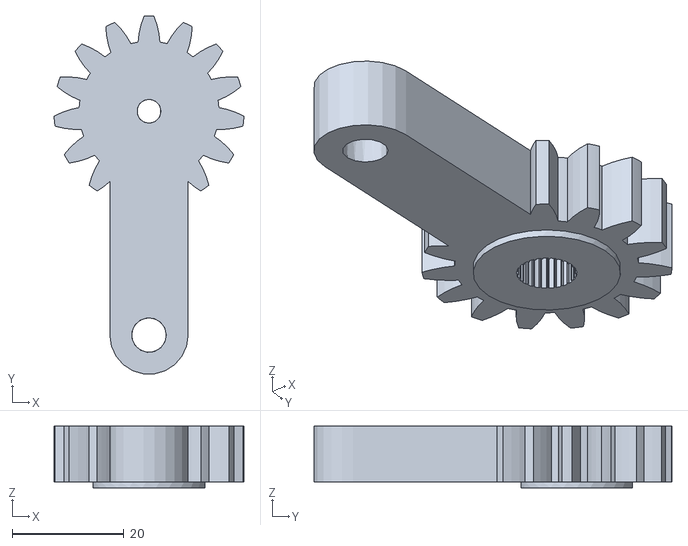
[picture p12: CAD file, 2026-08-02]
strew-hardware/CAD/카카오톡 받은 파일/(1EA)_Spur gear11_0719.stl
34.0 x 63.9 x 11.0
