Leechanyeop/STREW-VISION/strew-hardware/3D Printing/(2EA)Gripper_4.stl

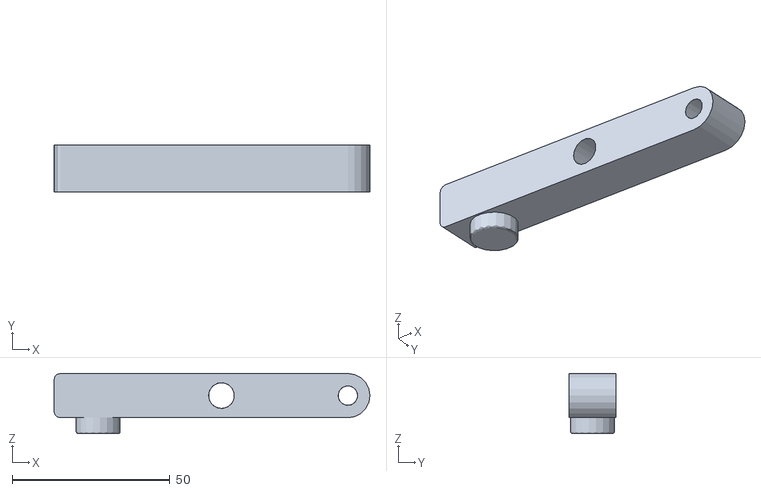
[picture p13: CAD file, 2026-07-07]
strew-hardware/3D Printing/(2EA)Gripper_4.stl
100.0 x 15.0 x 19.0
