Leechanyeop/STREW-VISION/strew-hardware/CAD/카카오톡 받은 파일/0727(1EA)Gripper_5.stl

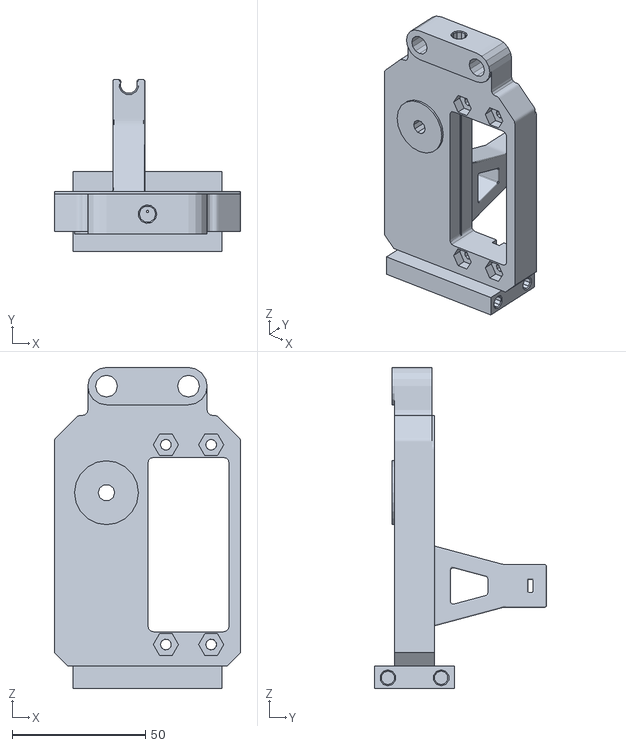
[picture p14: CAD file, 2026-08-02]
strew-hardware/CAD/카카오톡 받은 파일/0727(1EA)Gripper_5.stl
70.0 x 64.5 x 120.5
