Leechanyeop/STREW-VISION/strew-hardware/CAD/카카오톡 받은 파일/0727(1EA)_Gripper_7.stl

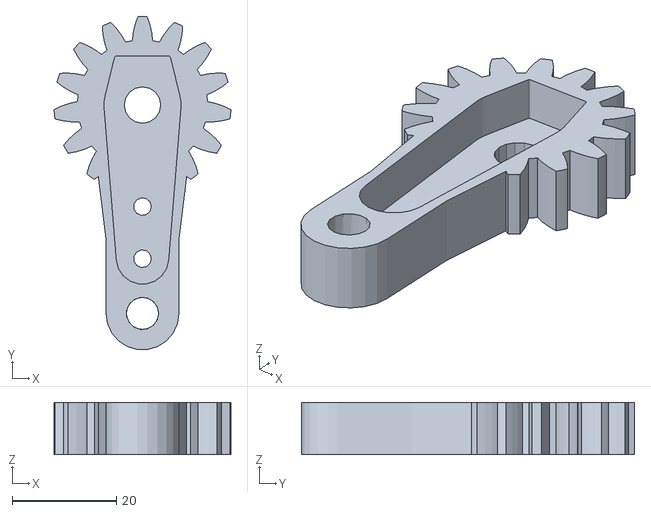
[picture p15: CAD file, 2026-08-02]
strew-hardware/CAD/카카오톡 받은 파일/0727(1EA)_Gripper_7.stl
34.0 x 63.9 x 10.0
