Leechanyeop/STREW-VISION/strew-hardware/3D Printing/(1EA)1-IB-00_Idler Block.stl

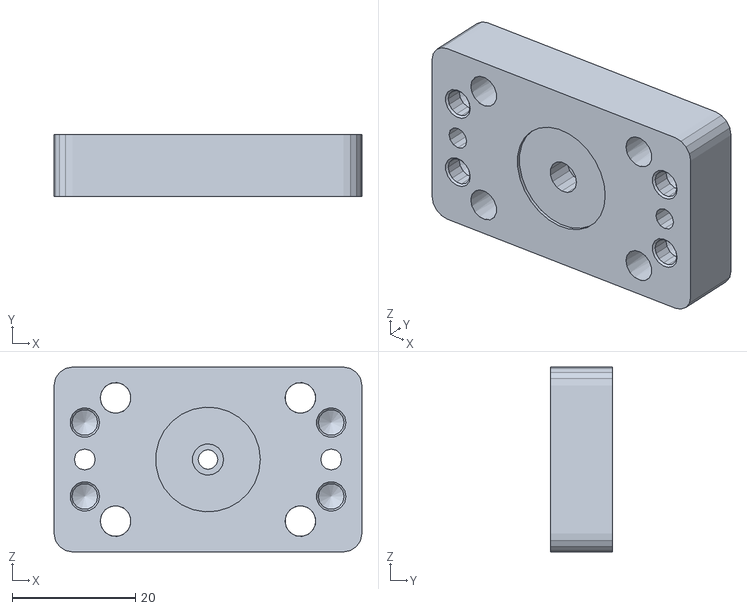
[picture p16: CAD file, 2026-07-07]
strew-hardware/3D Printing/(1EA)1-IB-00_Idler Block.stl
50.0 x 10.0 x 30.0
