Leechanyeop/STREW-VISION/strew-hardware/CAD/카카오톡 받은 파일/(4EA)1-SA-00_Servo Arm_0719.stl

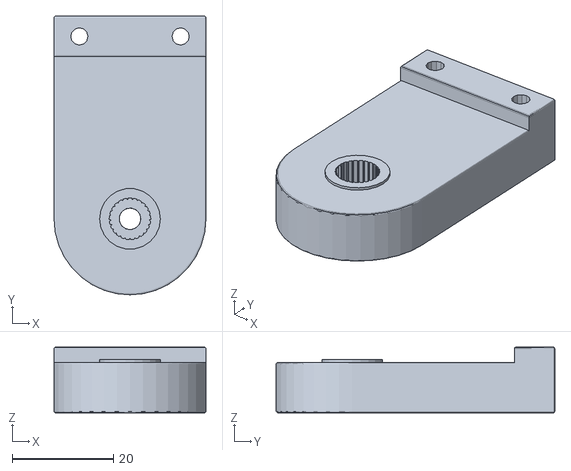
[picture p17: CAD file, 2026-08-02]
strew-hardware/CAD/카카오톡 받은 파일/(4EA)1-SA-00_Servo Arm_0719.stl
30.0 x 55.0 x 13.0
