Leechanyeop/STREW-VISION/strew-hardware/3D Printing/(1EA)1-BP-00_Bord Plate.stl

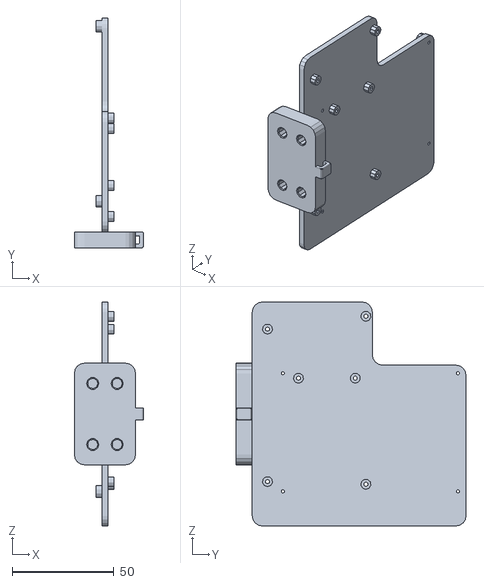
[picture p18: CAD file, 2026-07-07]
strew-hardware/3D Printing/(1EA)1-BP-00_Bord Plate.stl
34.0 x 113.0 x 110.0
