Leechanyeop/STREW-VISION/strew-hardware/CAD/카카오톡 받은 파일/(2EA)1-PC-00_Pi Camera_0614.stl

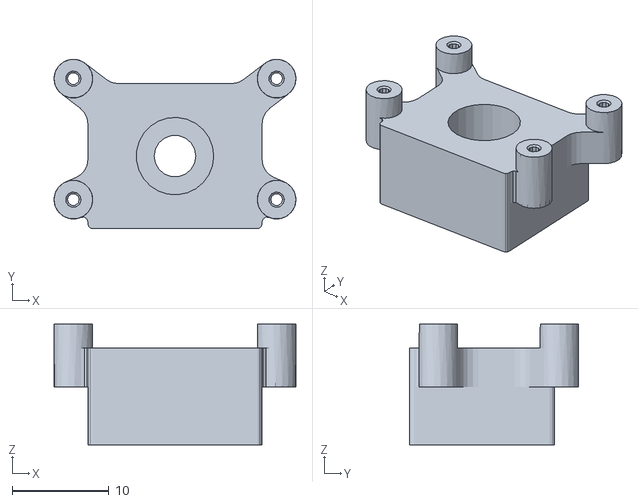
[picture p19: CAD file, 2026-08-02]
strew-hardware/CAD/카카오톡 받은 파일/(2EA)1-PC-00_Pi Camera_0614.stl
25.0 x 17.5 x 12.5
