Leechanyeop/STREW-VISION/strew-hardware/3D Printing/(1EA)1-MB-01__Motor Block.stl

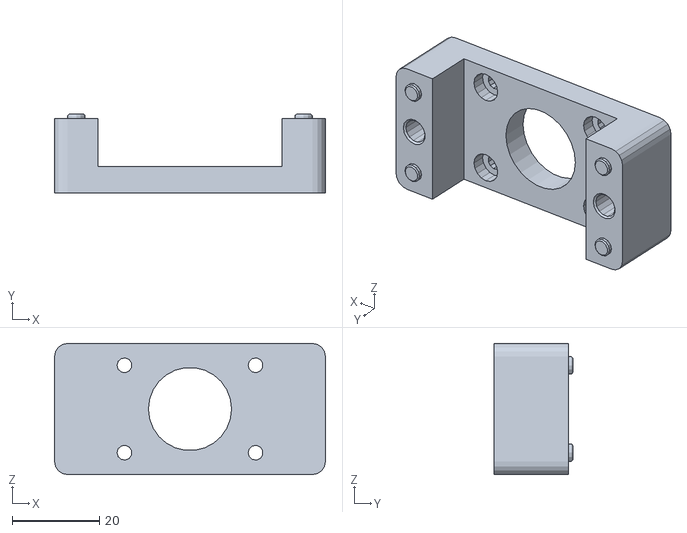
[picture p20: CAD file, 2026-07-07]
strew-hardware/3D Printing/(1EA)1-MB-01__Motor Block.stl
62.0 x 18.0 x 30.0
