Leechanyeop/STREW-VISION/strew-hardware/CAD/카카오톡 받은 파일/0727(1EA)_1-SRP-01_Servo rotary plate.stl

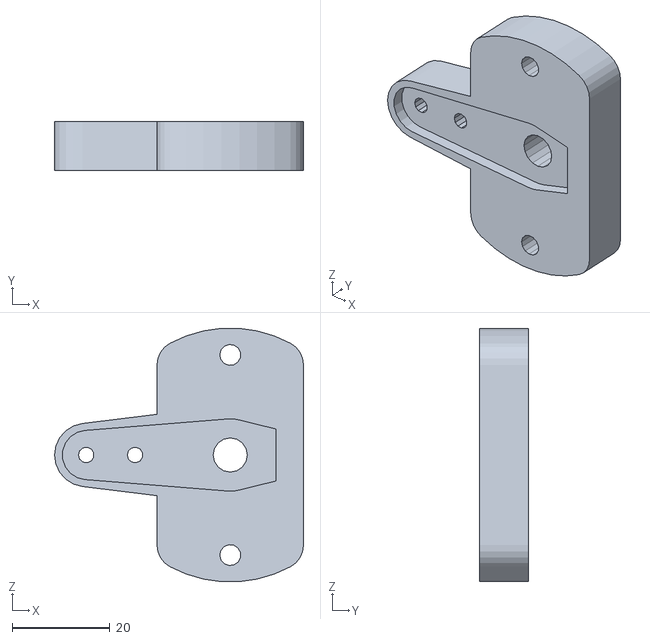
[picture p21: CAD file, 2026-08-02]
strew-hardware/CAD/카카오톡 받은 파일/0727(1EA)_1-SRP-01_Servo rotary plate.stl
51.0 x 10.0 x 51.9
