Leechanyeop/STREW-VISION/strew-hardware/3D Printing/(1EA)1-SRB-00_Servo rotary Base.stl

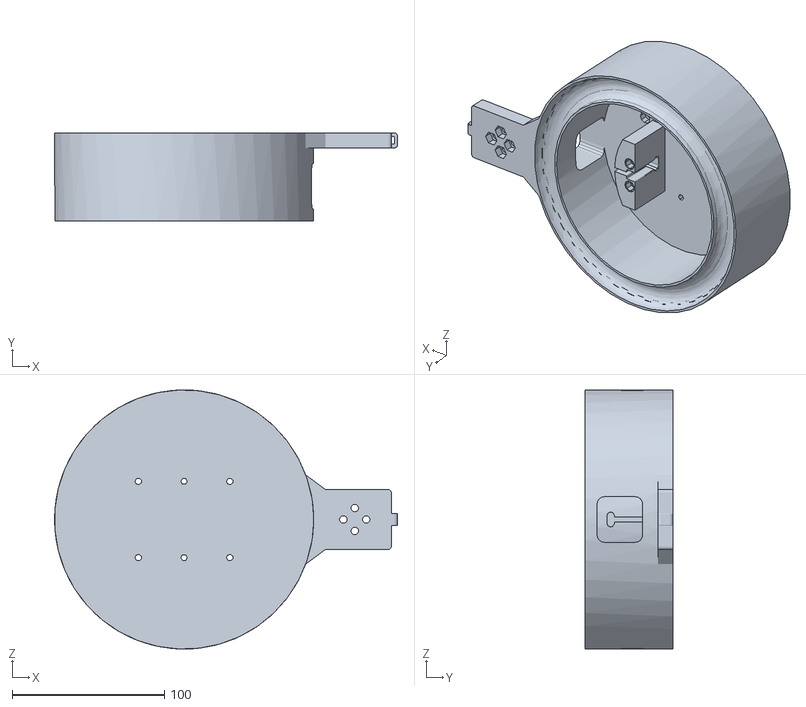
[picture p22: CAD file, 2026-07-07]
strew-hardware/3D Printing/(1EA)1-SRB-00_Servo rotary Base.stl
225.0 x 58.0 x 169.9
