Leechanyeop/STREW-VISION/strew-hardware/CAD/카카오톡 받은 파일/(1EA)1-BP-01_Base Plate_0720.stl

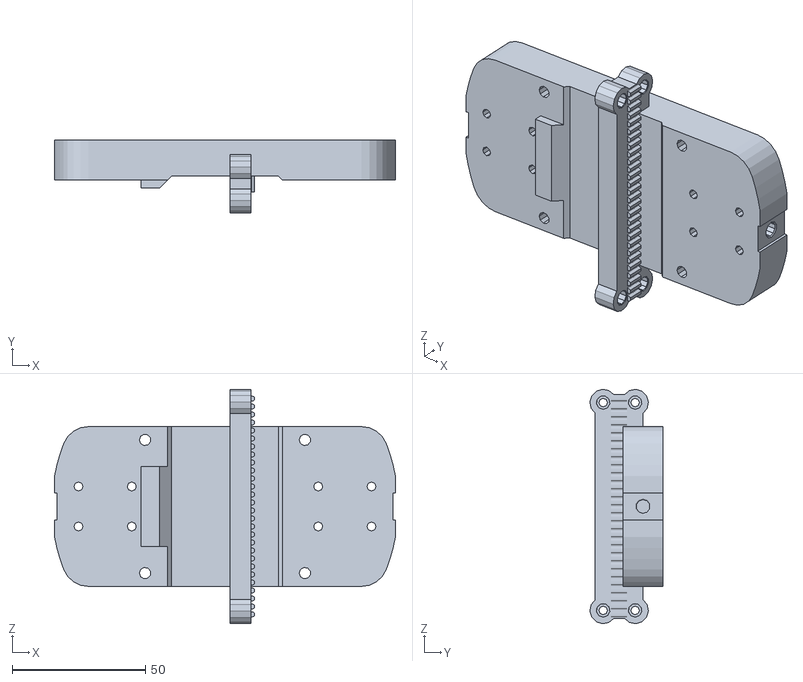
[picture p23: CAD file, 2026-08-02]
strew-hardware/CAD/카카오톡 받은 파일/(1EA)1-BP-01_Base Plate_0720.stl
128.0 x 27.5 x 88.0
