Leechanyeop/STREW-VISION/strew-hardware/3D Printing/(2EA)1-HC-00_handle cover.stl

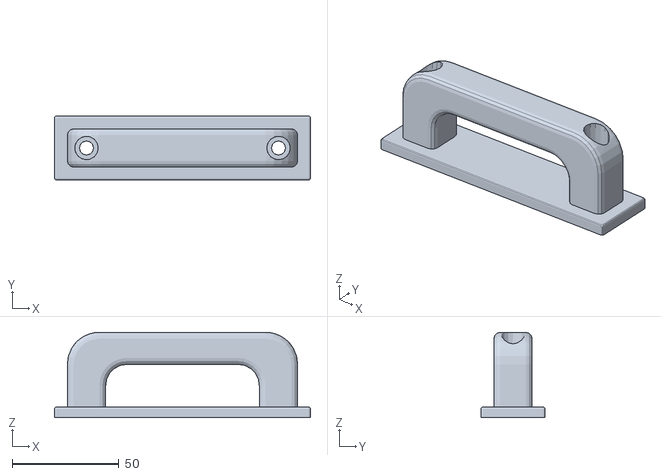
[picture p24: CAD file, 2026-07-07]
strew-hardware/3D Printing/(2EA)1-HC-00_handle cover.stl
120.0 x 30.0 x 40.0
