Leechanyeop/STREW-VISION/strew-hardware/CAD/카카오톡 받은 파일/(4EA)Gripper_3.stl

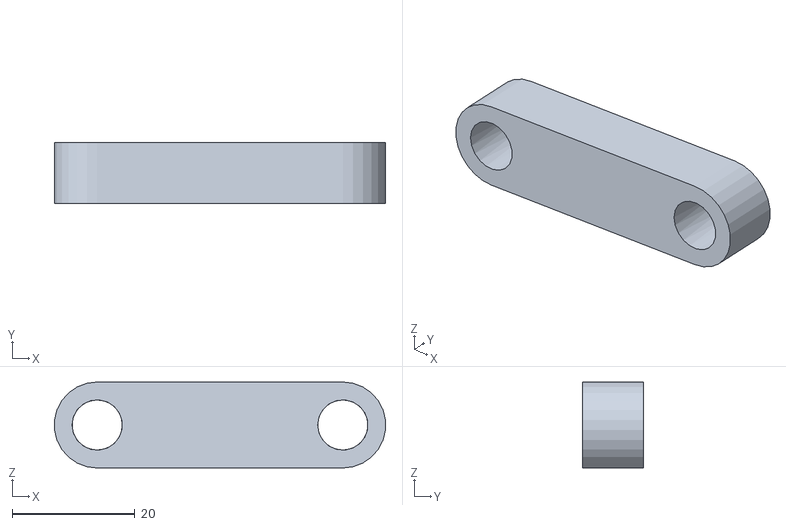
[picture p25: CAD file, 2026-07-07]
strew-hardware/CAD/카카오톡 받은 파일/(4EA)Gripper_3.stl
53.9 x 10.0 x 14.0
