Leechanyeop/STREW-VISION/strew-hardware/3D Printing/(7EA)1-SB-00_Sensor Bracket.stl

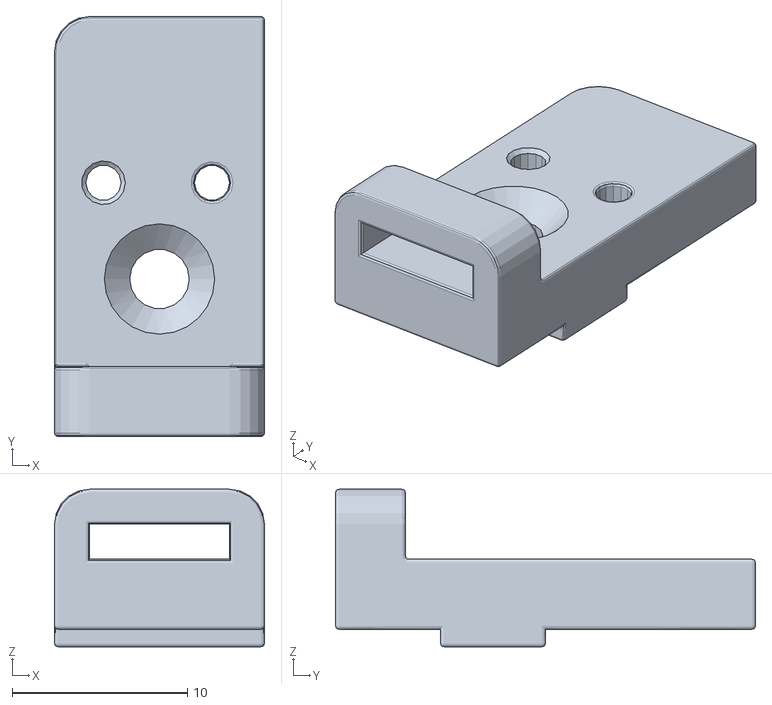
[picture p26: CAD file, 2026-07-07]
strew-hardware/3D Printing/(7EA)1-SB-00_Sensor Bracket.stl
12.0 x 24.0 x 9.00
