Leechanyeop/STREW-VISION/strew-hardware/3D Printing/(4EA)1-SA-00_Servo Arm.stl

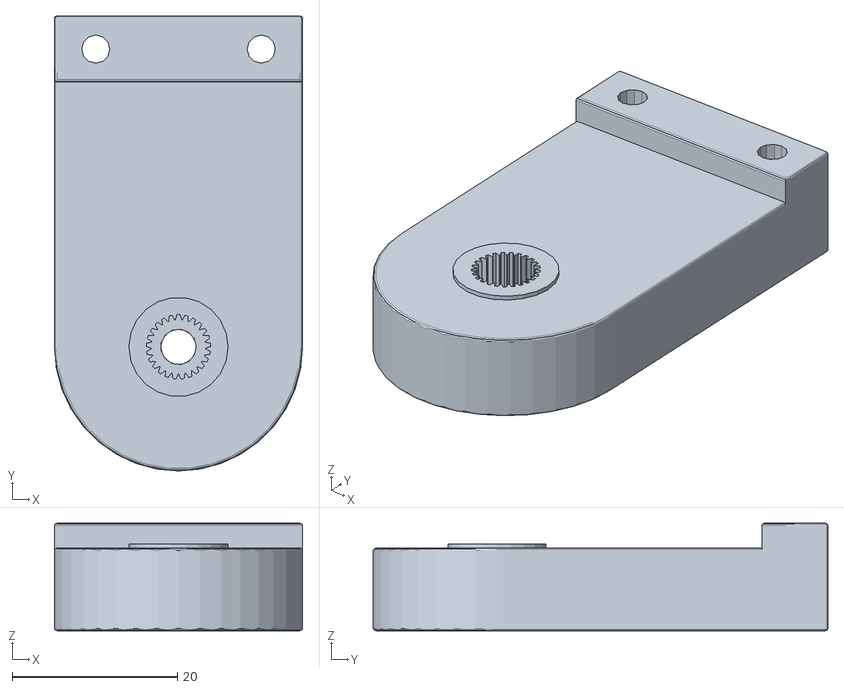
[picture p27: CAD file, 2026-07-07]
strew-hardware/3D Printing/(4EA)1-SA-00_Servo Arm.stl
30.0 x 55.0 x 13.0
