Leechanyeop/STREW-VISION/strew-hardware/3D Printing/(5EA)1-JBC-00_Joint Box Cover.stl

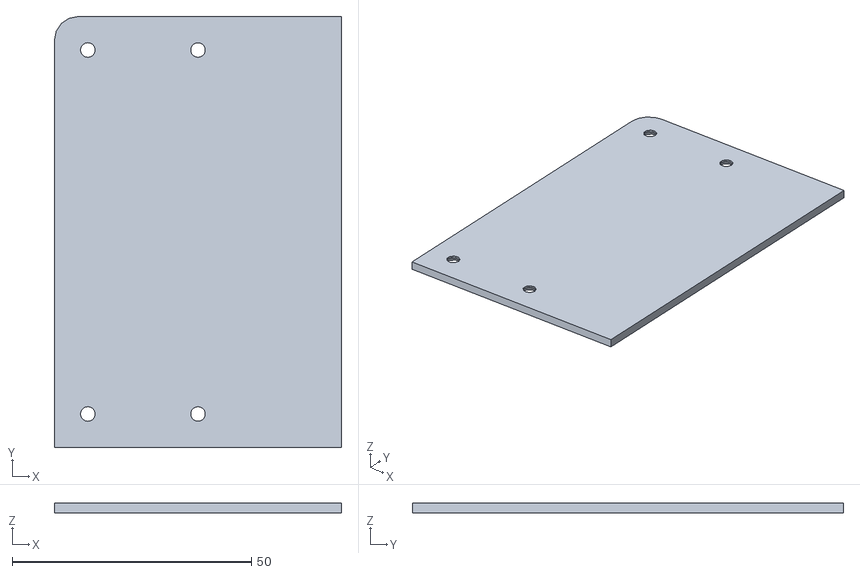
[picture p28: CAD file, 2026-07-07]
strew-hardware/3D Printing/(5EA)1-JBC-00_Joint Box Cover.stl
60.0 x 90.0 x 2.00
