Leechanyeop/STREW-VISION/strew-hardware/3D Printing/(1EA)1-MB-00__Motor Block.stl

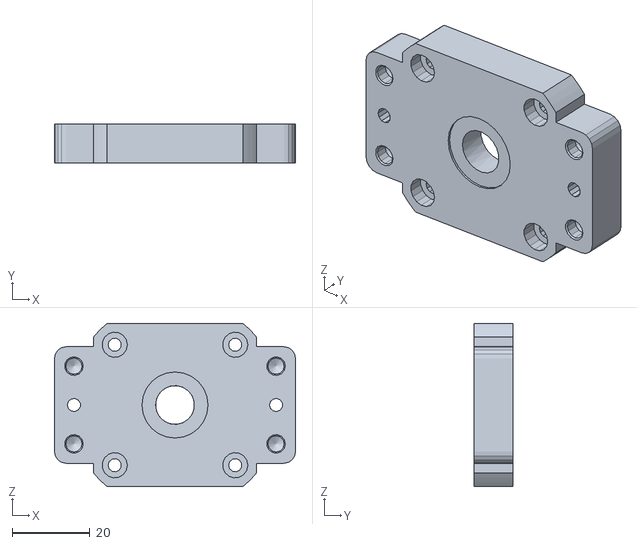
[picture p29: CAD file, 2026-07-07]
strew-hardware/3D Printing/(1EA)1-MB-00__Motor Block.stl
62.0 x 10.0 x 42.0
