Leechanyeop/STREW-VISION/strew-hardware/3D Printing/(5EA)Flowerpot_1.stl

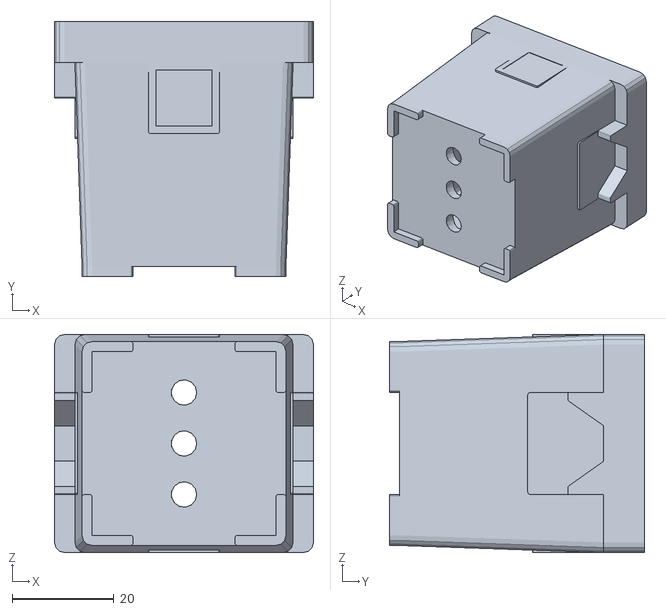
[picture p30: CAD file, 2026-07-07]
strew-hardware/3D Printing/(5EA)Flowerpot_1.stl
50.8 x 50.0 x 42.8
