Leechanyeop/STREW-VISION/strew-hardware/3D Printing/(1EA)1-DjbB-00_Dual Joint Box Base.stl

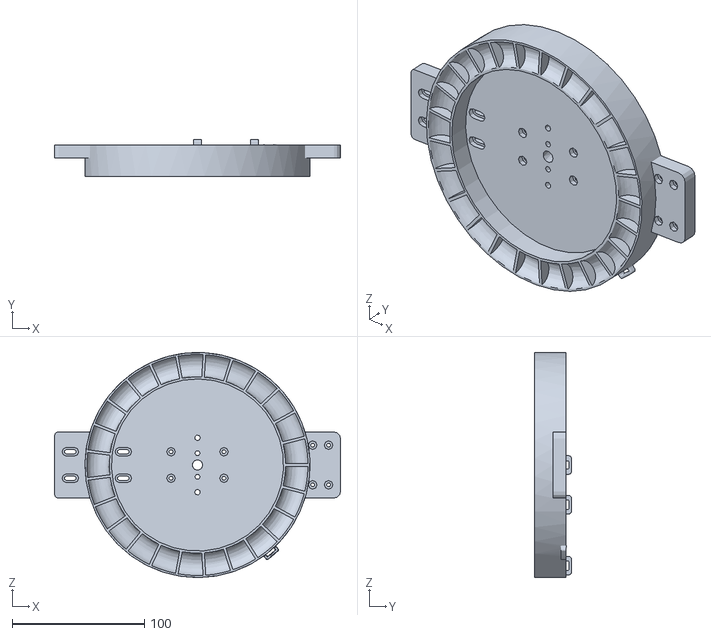
[picture p31: CAD file, 2026-07-07]
strew-hardware/3D Printing/(1EA)1-DjbB-00_Dual Joint Box Base.stl
216.0 x 28.0 x 170.0
