Leechanyeop/STREW-VISION/strew-hardware/3D Printing/(1EA)1-SA-02_Servo Arm.stl

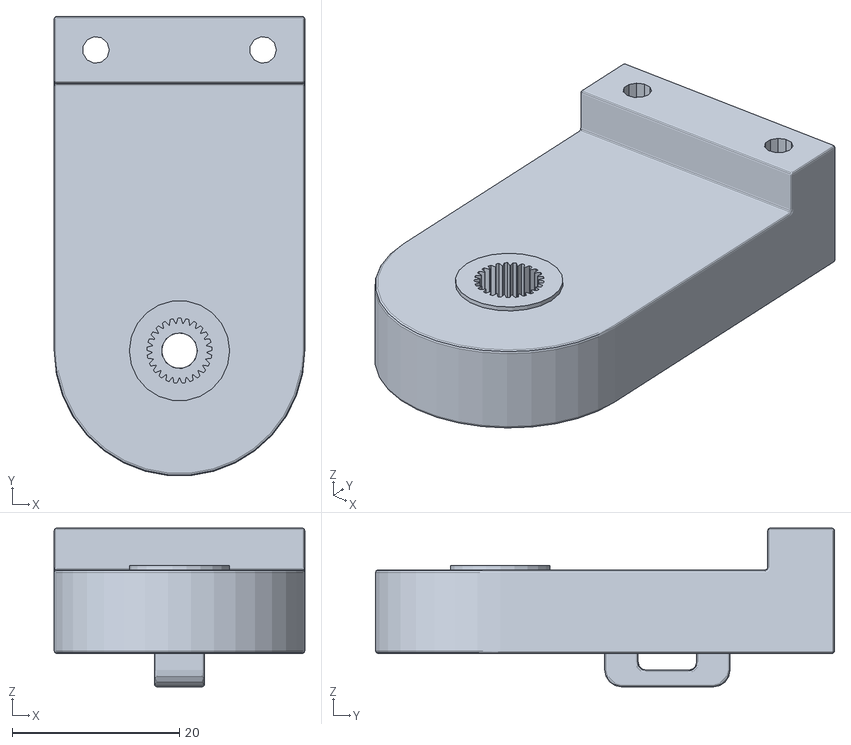
[picture p32: CAD file, 2026-07-07]
strew-hardware/3D Printing/(1EA)1-SA-02_Servo Arm.stl
30.0 x 54.9 x 19.0
