Leechanyeop/STREW-VISION/strew-hardware/3D Printing/(1EA)Spur gear2.stl

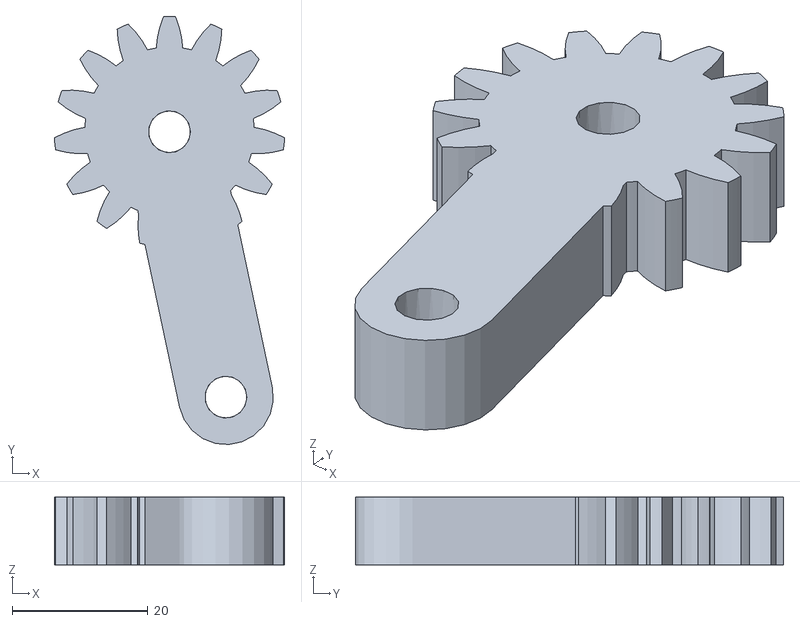
[picture p33: CAD file, 2026-07-07]
strew-hardware/3D Printing/(1EA)Spur gear2.stl
34.0 x 63.1 x 10.0
