Leechanyeop/STREW-VISION/strew-hardware/3D Printing/(1EA)1-SDL-00_Sensor Disk Limit.stl

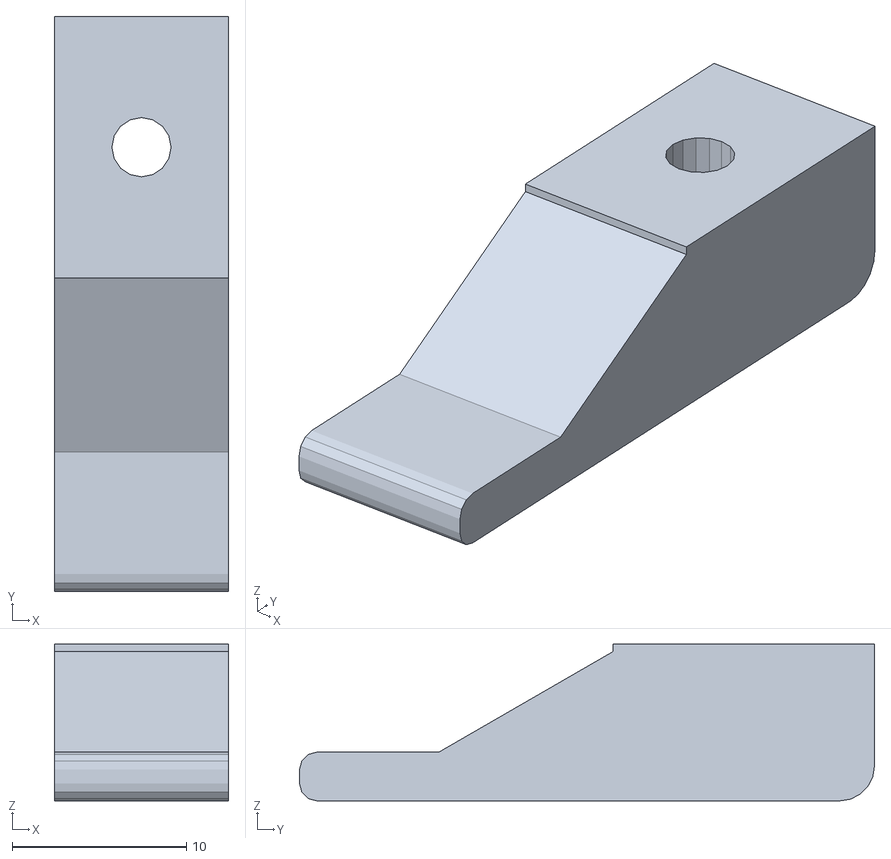
[picture p34: CAD file, 2026-07-07]
strew-hardware/3D Printing/(1EA)1-SDL-00_Sensor Disk Limit.stl
10.0 x 33.0 x 9.00
