Leechanyeop/STREW-VISION/strew-hardware/3D Printing/(1EA)1-BFP-00_Belt fixing plate.stl

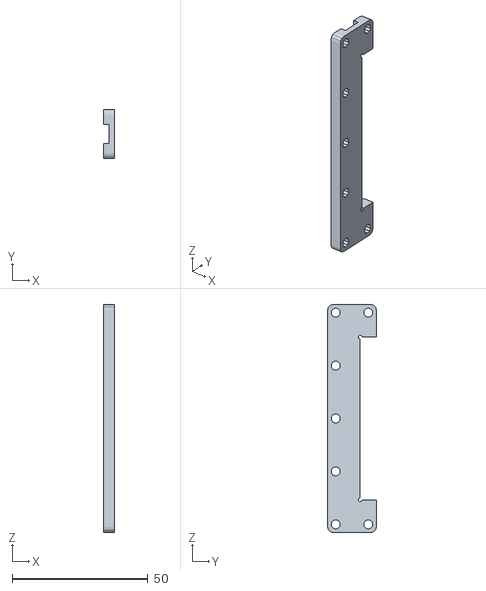
[picture p35: CAD file, 2026-07-07]
strew-hardware/3D Printing/(1EA)1-BFP-00_Belt fixing plate.stl
4.00 x 18.0 x 84.0
