Leechanyeop/STREW-VISION/strew-hardware/3D Printing/(26EA)Ball_Pi16.stl

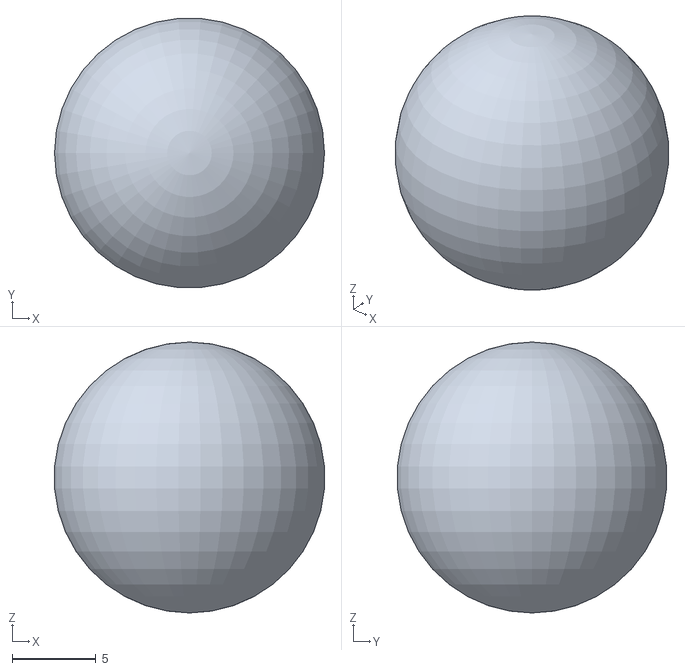
[picture p36: CAD file, 2026-07-07]
strew-hardware/3D Printing/(26EA)Ball_Pi16.stl
16.1 x 16.1 x 16.2
