Leechanyeop/STREW-VISION/strew-hardware/3D Printing/(1EA)1-BP-01_Base Plate.stl

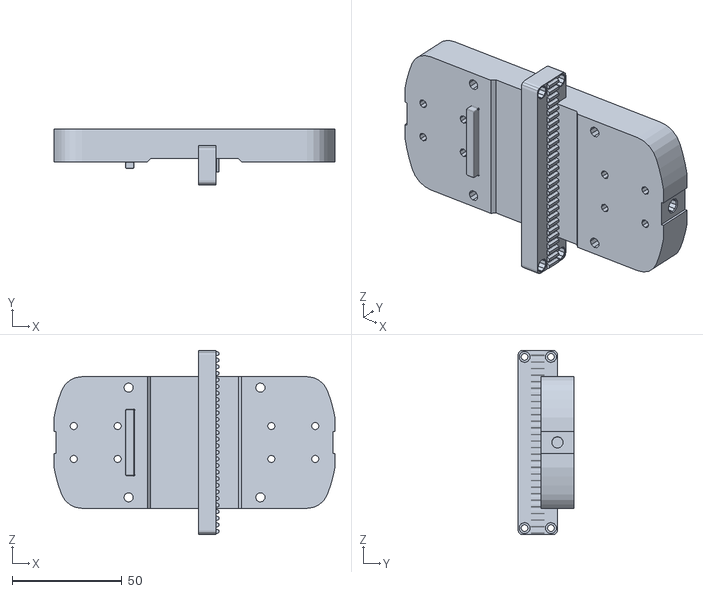
[picture p37: CAD file, 2026-07-07]
strew-hardware/3D Printing/(1EA)1-BP-01_Base Plate.stl
128.0 x 25.5 x 84.0
