Leechanyeop/STREW-VISION/strew-hardware/3D Printing/(1EA)1-SA-01_Servo Arm.stl

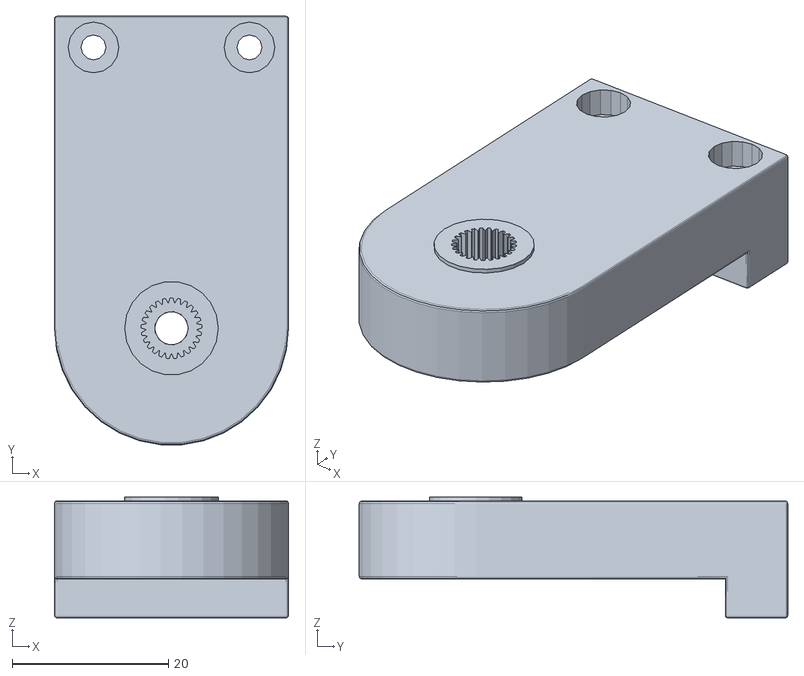
[picture p38: CAD file, 2026-07-07]
strew-hardware/3D Printing/(1EA)1-SA-01_Servo Arm.stl
30.0 x 54.9 x 15.5
