Leechanyeop/STREW-VISION/strew-hardware/3D Printing/(1EA)1-CCB-00_Cable Chain Bracket.stl

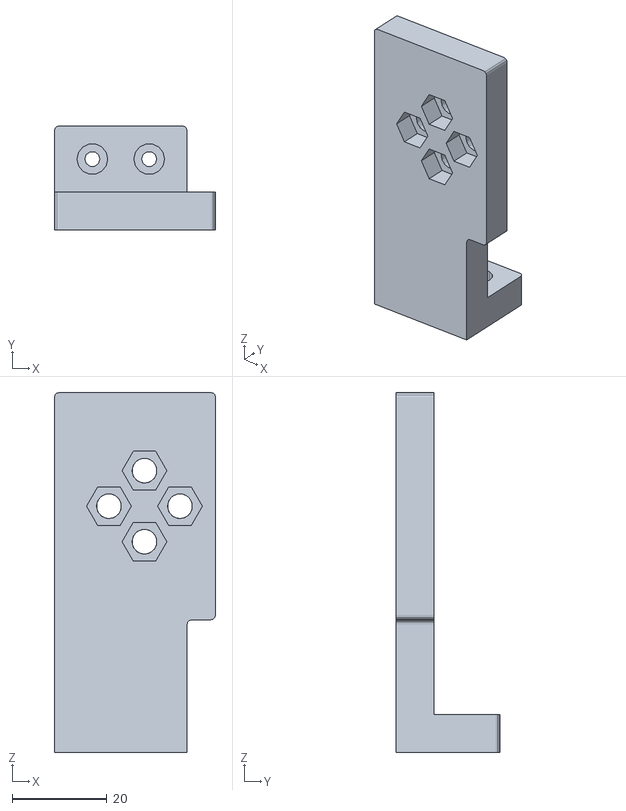
[picture p39: CAD file, 2026-07-07]
strew-hardware/3D Printing/(1EA)1-CCB-00_Cable Chain Bracket.stl
34.0 x 22.0 x 76.0
