Leechanyeop/STREW-VISION/(list of files, cad)

Other CAD files:
STREW_VISION_EEarchitect/DWG-002_Power_Supply.dwg
strew-hardware/3D Printing/(2EA)1-DJB-00_Dual Joint Box.stl
strew-hardware/3D Printing/(1EA)Spur gear1.stl
strew-hardware/3D Printing/(1EA)1-SRP-00_Servo rotary plate.stl
strew-hardware/3D Printing/(1EA)Gripper_5.stl
strew-hardware/CAD/cap2.ipt
strew-hardware/CAD/table.ipt
