Leechanyeop/STREW-VISION/JETSON_ROBOT/robot/state_machine.py

import os
import time
import threading
from typing import Any, Dict, Optional
from ai.detector.camera import create_vision_source

from cloud.api_client import CloudClient
from cloud.sync import CloudSync
from cloud.mqtt import MqttClient
from cloud.sensor_bridge import SensorBridge
from config.settings import Config
from robot.command import (
    CMD_RUN,
    CMD_RESUME,
    CMD_ACK,
    CMD_TASK,
    CMD_PING,
    EV_READY,
    EV_STATE,
    EV_COMPLETE,
    EV_ERROR,
    EV_PONG,
    STATE_VISION_READY,
    INSPECTION_VIEWS,
    DISEASE_STATUSES,
    status_to_task,
    aggregate_views,
)
from robot.uart import ArduinoLink

# [2026-07-21 UART Protocol v1.0]
# 하트비트: Jetson이 PING을 1초 주기로 보내고 Mega는 즉시 PONG. 이 시간(초) 넘게
# PONG이 없으면 Mega Offline로 판정한다(스펙: 3회 무응답 = Offline).
HEARTBEAT_INTERVAL_SEC = 1.0
HEARTBEAT_TIMEOUT_SEC = 5.0

# 병해충 의심 판독. 즉시 TASK를 내리지 않고 AWS에 판단 요청 후 관리자 응답을 기다린다.
DISEASE_SUSPECT_STATUSES = set(DISEASE_STATUSES)

# 관리자 판단 대기 중 폴링 간격(초).
DECISION_POLL_INTERVAL_SEC = 5.0


def build_mock_cycle_id() -> str:
    # AWS 미연동(개발/시뮬)일 때 cycle_id 대용. 실제로는 AWS task id를 쓴다.
    return f"mock-{int(time.time())}"


class RobotAgent:
    """Jetson(Master) 측 UART Protocol v1.0 구현.

    역할: AI(vision) 수행, DB(AWS) 저장, 관리자 승인 처리, UART 관리, 하트비트.
    모터/물리 동작은 전혀 안 한다(그건 Mega). Jetson은 명령(cmd)을 주고 상태(event)를 받는다.
    """

    def __init__(self, cfg: Config) -> None:
        self.cfg = cfg
        self.cloud = CloudClient(cfg.aws_api_base, cfg.api_key)
        self.vision = create_vision_source(
            cfg.vision_mode, cfg.csi_camera_index, cfg.frame_width, cfg.frame_height, cfg.yolo_model_path,
        )

        # [2026-08-04] 대시보드 라이브 스트림(MJPEG) - 로봇 검사 카메라(SharedFrameCamera)를 그대로
        # 공유해 송출한다(별도 프로세스 X - 카메라 단일 소유 충돌 방지). 검사 시 나온 박스가 얹힌다.
        # mock 모드엔 get_stream_frame이 없어 자동 스킵. STREAM_ENABLED=false 로 끌 수 있음.
        self.stream_server = None
        if os.getenv("STREAM_ENABLED", "true").lower() in ("1", "true", "yes") and hasattr(self.vision, "get_stream_frame"):
            try:
                from robot.vision_stream import VisionStreamServer
                self.stream_server = VisionStreamServer(
                    self.vision.get_stream_frame, port=int(os.getenv("STREAM_PORT", "8090")))
            except Exception as e:
                print(f"[stream] 시작 실패(무시하고 계속): {e}")

        self.arduino = ArduinoLink(cfg.arduino_port, cfg.arduino_baudrate)
        self.mqtt_client = MqttClient()
        self.cloud_sync = CloudSync(self.cloud)

        # ESP32 센서 브리지 (기본 비활성 - 서버가 직접 MQTT 구독하는 방식이 기본).
        self.sensor_bridge = (
            SensorBridge(self.cloud, cfg.robot_id, cfg.sensor_forward_interval_sec)
            if cfg.aws_enabled and cfg.mqtt_sensor_topic else None
        )
        if self.sensor_bridge is not None:
            self.mqtt_client.on_sensor = self.sensor_bridge.handle_payload

        # [2026-07-23] OTA 원격 자동 업데이트 서비스 - update 토픽 구독 + UpdateManager 연결.
        self.ota_service = None
        if getattr(cfg, "ota_enabled", False):
            try:
                from updater.ota_service import OtaService

                self.ota_service = OtaService(cfg, self.mqtt_client, self.cloud, arduino_link=self.arduino)
            except Exception as e:
                print(f"[OTA] 초기화 실패(무시하고 계속): {e}")

        self.mqtt_client.connect(
            cfg.aws_mqtt_broker, cfg.aws_mqtt_topic, cfg.aws_mqtt_port,
            sensor_topic=cfg.mqtt_sensor_topic if self.sensor_bridge is not None else None,
            update_topic=cfg.ota_update_topic if self.ota_service is not None else None,
        )

        # [2026-07-25 v2.0] 상태 관리 SQLite (Source of Truth). STATE 받을 때마다 저장하고
        # Recovery의 기준으로 삼는다. DB 초기화 실패해도 로봇 동작은 계속(무시)한다.
        self.state_db = None
        try:
            from storage.state_db import StateDB

            self.state_db = StateDB(cfg.state_db_path)
        except Exception as e:
            print(f"[SQLite] 초기화 실패(무시하고 계속): {e}")

        # [B] 부팅 시 운영 정책값(system_config)을 AWS로 1회 보고 - 대시보드 읽기전용 표시용.
        # 실패해도 무시(오프라인 내성). Dashboard→Jetson 역방향 반영은 아직 없음(Decision 009).
        if cfg.aws_enabled and self.state_db is not None:
            try:
                self.cloud_sync.try_send(
                    self.cloud.post_robot_config,
                    robot_id=cfg.robot_id,
                    config=self.state_db.get_all_config(),
                )
            except Exception as e:
                print(f"[Config] 설정 보고 실패(무시): {e}")

        # 현재 진행 중인 Cycle의 AWS task (COMPLETE/ERROR를 이 task_id로 릴레이).
        self.current_task: Optional[Dict[str, Any]] = None
        self.cycle_active: bool = False
        self._cycles_done: int = 0   # 완료한 사이클 수(부팅 이후). cycle_count 목표 도달 판단용.

        # [Phase C] Multi-View Inspection: 현재 셀에서 지금까지 촬영한 View 판독 결과 누적.
        # 셀이 바뀌면(첫 VISION_READY가 TOP이면) 초기화한다.
        self._inspect_cell: Optional[int] = None
        self._inspect_results: list = []

        # 관리자 판단 대기 중 여부. 이 동안은 하트비트 오프라인 판정을 유예한다 -
        # 리스너 스레드가 판단 폴링으로 블로킹돼서 PONG을 못 읽는 것뿐이지 Mega가 죽은
        # 게 아니기 때문.
        self.awaiting_decision: bool = False

        # 하트비트 상태.
        self.last_pong_time: float = time.monotonic()
        self.mega_online: bool = True
        self._offline_reported: bool = False

        # UART 읽기는 리스너 스레드 하나만 한다(단일 소유자). 쓰기는 write_lock으로 보호됨.
        self._listener = threading.Thread(target=self._uart_listener_loop, daemon=True)
        self._heartbeat = threading.Thread(target=self._heartbeat_loop, daemon=True)
        self._scheduler = threading.Thread(target=self._schedule_loop, daemon=True)
        self._listener.start()
        self._heartbeat.start()
        self._scheduler.start()

    # ---------------------------------------------------------------------
    # 하트비트: 1초마다 PING, HEARTBEAT_TIMEOUT_SEC 넘게 PONG 없으면 Offline.
    # ---------------------------------------------------------------------
    def _heartbeat_loop(self) -> None:
        _status_tick = 0
        while True:
            time.sleep(HEARTBEAT_INTERVAL_SEC)
            self.arduino.send_json_line({"cmd": CMD_PING})

            # [Runtime Status] 5초마다 젯슨/Mega/MQTT 연결 상태를 AWS로 보고(실패 무시).
            _status_tick += 1
            if _status_tick >= 5 and self.cfg.aws_enabled:
                _status_tick = 0
                state = "WAIT" if self.awaiting_decision else ("RUNNING" if self.cycle_active else "IDLE")
                self.cloud_sync.try_send(
                    self.cloud.post_status,
                    robot_id=self.cfg.robot_id,
                    status={
                        "jetson": "ONLINE",
                        "mega": "CONNECTED" if self.mega_online else "OFFLINE",
                        "mqtt": "CONNECTED" if getattr(self.mqtt_client, "connected", False) else "DISCONNECTED",
                        "state": state,
                        "heartbeat": time.strftime("%H:%M:%S") if self.mega_online else None,
                    },
                )

            if self.awaiting_decision:
                continue  # 판단 대기 중엔 오프라인 판정 유예

            silence = time.monotonic() - self.last_pong_time
            if silence > HEARTBEAT_TIMEOUT_SEC:
                if not self._offline_reported:
                    self.mega_online = False
                    self._offline_reported = True
                    print(f"[!!!] Mega Offline - PONG {silence:.0f}초간 없음 (연결/전원 확인 필요)")
                    if self.cfg.aws_enabled and self.current_task is not None:
                        self.cloud_sync.try_send(
                            self.cloud.post_response,
                            robot_id=self.cfg.robot_id,
                            task_id=self.current_task["id"],
                            execute_task="ERROR",
                            completion_sign="ERROR",
                            message="Mega heartbeat timeout (offline)",
                            payload={"reason": "heartbeat_timeout"},
                        )
            else:
                if self._offline_reported:
                    print("[복구] Mega 하트비트 재개 - 다시 Online")
                self.mega_online = True
                self._offline_reported = False

    # ---------------------------------------------------------------------
    # 수신 이벤트 처리 루프.
    # ---------------------------------------------------------------------
    def _uart_listener_loop(self) -> None:
        while True:
            msg = self.arduino._read_json_line()
            if msg is None:
                continue

            event = msg.get("event")
            if event == EV_PONG:
                self.last_pong_time = time.monotonic()
                continue
            # 어떤 핸들러에서 예외가 나도 리스너 스레드(단일 소유자)는 죽지 않는다.
            # 스레드가 죽으면 PONG 수신이 멈춰 Mega가 Offline으로 오판되므로,
            # 이벤트 처리 실패는 로그만 남기고 다음 이벤트를 계속 받는다.
            try:
                if event == EV_READY:
                    self._on_ready()
                elif event == EV_STATE:
                    self._on_state(msg)
                elif event == EV_COMPLETE:
                    self._on_complete(msg)
                elif event == EV_ERROR:
                    self._on_error(msg)
                # 알 수 없는 event는 무시.
            except Exception as e:
                print(f"[UART] 이벤트 처리 오류({event}): {e} - 리스너는 계속 동작")

    # READY: Mega 부팅/리셋 완료.
    # [2026-07-25 Phase B] 먼저 SQLite에 미완료 작업(status=RUNNING)이 남아있는지 확인한다.
    # 있으면 전원/네트워크가 끊겼다 복구된 상황이므로 RESUME(셀 단위 재개)을 보내고,
    # 없으면 기존대로 새 작업을 확보해 RUN을 보낸다. Recovery의 기준은 EEPROM이 아니라
    # Jetson SQLite(Source of Truth)다.
    def _on_ready(self) -> None:
        self.last_pong_time = time.monotonic()  # READY도 살아있음의 신호
        print("[READY] Mega 부팅 완료 - Cycle 준비")

        recovery = self._check_recovery()
        if recovery is not None:
            cycle_id = recovery.get("cycle_id")
            cell = recovery.get("cell_id")
            task = recovery.get("task")
            state = recovery.get("state")
            # 복구 대상 cycle을 현재 작업으로 복원(이후 STATE/COMPLETE를 이 id로 릴레이).
            self.current_task = {"id": cycle_id} if cycle_id else None
            self.cycle_active = True
            self.arduino.send_json_line({
                "cmd": CMD_RESUME, "cycle_id": cycle_id, "cell": cell, "task": task, "state": state,
            })
            print(f"[RESUME] cycle={cycle_id} cell={cell}부터 셀 단위 재개")
            return

        # [연속 순회] 부팅하면 바로 첫 사이클 시작. 이후엔 사이클이 끝날 때마다 자동 재시작한다.
        self._begin_new_cycle()

    def _begin_new_cycle(self) -> bool:
        # 신규 Cycle 시작(READY 자동 / 스케줄 트리거 공용). Mega가 IDLE일 때만 의미 있음. 성공 시 True.
        if self.cfg.aws_enabled:
            try:
                task = self.cloud.next_task(self.cfg.robot_id)
                if not task:
                    # 큐에 대기 작업이 없으면 이 사이클용 task를 직접 생성한다(자율 운영).
                    # 이렇게 해야 진행도(post_progress)가 붙을 대상이 생겨 대시보드에 뜬다.
                    task = self.cloud.create_task(self.cfg.robot_id, "CYCLE")
                    print(f"[CYCLE] 대기 작업 없음 - 자체 생성 task={task.get('id')}")
            except Exception as e:
                print(f"[CYCLE] AWS 작업 조회/생성 실패({e}) - 보류")
                return False
            if not task:
                print("[CYCLE] task 확보 실패 - 보류")
                return False
        else:
            task = {"id": build_mock_cycle_id()}

        # [Config Sync] 새 Cycle 시작 전에 대시보드가 설정한 운영 정책값을 받아 적용(실패 무시).
        if self.cfg.aws_enabled and self.state_db is not None:
            try:
                desired = self.cloud.get_robot_config(self.cfg.robot_id)
                for k, v in (desired or {}).items():
                    self.state_db.set_config(k, v)
                if desired:
                    print(f"[Config] 대시보드 설정 적용: {desired}")
            except Exception as e:
                print(f"[Config] desired config 적용 실패(무시): {e}")

        self.current_task = task
        self.cycle_active = True
        cycle_id = task["id"]
        self._db_update(cycle_id=cycle_id, cell_id=None, state="RUN", status="RUNNING")
        self.arduino.send_json_line({"cmd": CMD_RUN, "cycle_id": cycle_id})
        print(f"[RUN] cycle_id={cycle_id} 전송")
        return True

    def _schedule_active(self) -> bool:
        # 대시보드 Task Scheduler에 활성 스케줄(entries)이 있으면 True(부팅 자동순회 억제).
        if not self.cfg.aws_enabled:
            return False
        try:
            sch = self.cloud.get_schedule(self.cfg.robot_id)
        except Exception:
            return False
        return bool(sch and sch.get("enabled", True) and (sch.get("entries") or []))

    def _schedule_loop(self) -> None:
        # 주간 스케줄(요일×시각)을 20초마다 확인해, 예약 시각(정시)에 Mega가 IDLE이면 순회 시작.
        DAYS = ["MON", "TUE", "WED", "THU", "FRI", "SAT", "SUN"]
        last_fired = None
        while True:
            time.sleep(20)
            if not self.cfg.aws_enabled:
                continue
            try:
                sch = self.cloud.get_schedule(self.cfg.robot_id)
            except Exception:
                continue
            if not sch or not sch.get("enabled", True):
                continue
            entries = sch.get("entries") or []
            if not entries:
                continue
            now = time.localtime()
            day = DAYS[now.tm_wday]
            hhmm = time.strftime("%H:00", now)   # 정시 슬롯 매칭
            slot = f"{day}|{hhmm}"
            if slot == last_fired:
                continue
            if any(e.get("day") == day and e.get("time") == hhmm for e in entries):
                if not self.cycle_active and self.mega_online:
                    last_fired = slot
                    print(f"[SCHEDULE] {slot} 예약 순회 시작")
                    self._begin_new_cycle()

    # SQLite에 미완료 작업이 남아있는지 확인. 있으면 그 레코드(dict)를, 없으면 None.
    # 판정: status가 RUNNING이고 실제 진행된 셀(cell_id)이 있어야 재개 의미가 있다.
    # (RUN만 기록되고 STATE 전이면 cell_id=None -> 그냥 새 RUN이 낫다.)
    def _check_recovery(self) -> Optional[Dict[str, Any]]:
        if self.state_db is None:
            return None
        try:
            cur = self.state_db.get_current_task()
        except Exception as e:
            print(f"[Recovery] SQLite 조회 실패(무시, 새 RUN으로): {e}")
            return None
        if cur and cur.get("status") == "RUNNING" and cur.get("cell_id") is not None:
            return cur
        return None

    # STATE: 상태 완료 보고. DB 저장(릴레이) 후 ACK. VISION_READY면 AI 수행 후 TASK.
    def _on_state(self, msg: Dict[str, Any]) -> None:
        seq = msg.get("seq")
        cell = msg.get("cell")
        state = msg.get("state")

        # [v2.0] Source of Truth 먼저 갱신 - AWS/네트워크가 끊겨도 Recovery 가능해야 하므로
        # AWS 릴레이보다 로컬 SQLite 저장이 우선이다.
        cycle_id = self.current_task["id"] if self.current_task else None
        self._db_update(cycle_id=cycle_id, cell_id=cell, state=state, status="RUNNING")

        # 진행상황을 AWS로 릴레이(있으면 좋은 정보 - 실패해도 무시).
        # progress(%) = 현재 Cell / 전체 Cell 수(system_config.total_cells) * 100.
        if self.cfg.aws_enabled and self.current_task is not None:
            self.cloud_sync.try_send(
                self.cloud.post_progress,
                robot_id=self.cfg.robot_id,
                task_id=self.current_task["id"],
                target=f"cell_{cell}" if cell is not None else None,
                state=state,
                progress=self._cell_progress_percent(cell),
            )

        # 스펙: STATE는 반드시 ACK. VISION_READY도 ACK를 먼저 보낸다.
        self.arduino.send_json_line({"cmd": CMD_ACK, "seq": seq})

        # VISION_READY는 "완료 보고"가 아니라 "AI 요청 동기화 지점".
        # [Phase C ②] Multi-View: view별로 AI 추론·누적. View 진행은 위에서 이미 보낸 ACK로
        # Mega가 자체 순회하며, 4개 다 찍히면(마지막 View) 종합 판정 -> TASK를 추가로 보낸다.
        if state == STATE_VISION_READY:
            self._handle_vision_ready(cell, msg.get("view"))

    # [Phase C] Multi-View Inspection의 Decision Planner (Jetson 측).
    # Mega가 View 하나에서 VISION_READY(view=...)를 보낼 때마다 호출된다.
    # 설계 결정(②): NEXT_VIEW 없이 STATE->ACK 핸드셰이크만으로 View가 넘어간다.
    #   - ACK는 _on_state에서 이미 보냈으므로 Mega는 자동으로 다음 View로 이동한다.
    #   - 이 함수는 View 판독을 누적만 하고, 마지막(4번째) View 후에만 TASK를 추가로 보낸다.
    def _handle_vision_ready(self, cell, view) -> None:
        cycle_id = self.current_task["id"] if self.current_task else None

        # 셀이 바뀌면 누적 초기화 (새 셀의 첫 View).
        if self._inspect_cell != cell:
            self._inspect_cell = cell
            self._inspect_results = []

        vision = self.vision.read().to_payload()
        status = vision.get("status")
        confidence = vision.get("confidence")

        # 이 View 결과를 SQLite에 저장(관리자가 나중에 View별로 확인).
        if self.state_db is not None:
            try:
                self.state_db.add_image(cycle_id=cycle_id, cell_id=cell, view=view,
                                        status=status, confidence=confidence, image_path=None)
            except Exception as e:
                print(f"[SQLite] inspection_image 저장 실패(무시): {e}")

        self._inspect_results.append({"view": view, "status": status, "confidence": confidence})
        done_views = len(self._inspect_results)
        target_views = self._target_view_count()
        print(f"[VIEW] cell={cell} view={view} status={status} conf={confidence} ({done_views}/{target_views})")

        # 아직 View가 남았으면 아무것도 안 한다 - ACK(이미 보냄)로 Mega가 다음 View를 진행한다.
        if done_views < target_views:
            return

        # 모든 View(4장) 촬영 완료 -> 종합 판정.
        final_status, best_conf = aggregate_views(self._inspect_results)
        print(f"[INSPECT] cell={cell} 종합판정: {final_status} (conf={best_conf})")

        # 종합 결과를 AWS에 하나의 vision 이벤트로 기록(판단요청용 id 확보).
        vision_event_id = None
        if self.cfg.aws_enabled:
            try:
                event = self.cloud.post_vision_event(self.cfg.robot_id, {
                    "status": final_status, "confidence": best_conf,
                    "views": self._inspect_results, "cell_id": cell,
                })
                vision_event_id = event.get("id")
            except Exception as e:
                print(f"[!] vision 이벤트 기록 실패(무시하고 진행): {e}")

        # 병해충 의심이면 관리자 승인(4 View 결과 기반), 정상이면 자동 진행.
        # [Phase C] 4 View 판독 결과를 판단요청에 함께 실어 관리자가 표로 확인하게 한다.
        if self.cfg.aws_enabled and final_status in DISEASE_SUSPECT_STATUSES:
            final_status = self._await_admin_decision(final_status, vision_event_id, self._inspect_results, cell=cell)

        task = status_to_task(final_status)
        # [B 설계] Cell 단위 최종 종합 판정을 detection_log에 1건 기록 (View별 원본은 위에서 저장).
        if self.state_db is not None:
            try:
                self.state_db.add_detection(cycle_id=cycle_id, cell_id=cell,
                                            detection_class=final_status, confidence=best_conf, task=task)
            except Exception as e:
                print(f"[SQLite] detection_log 저장 실패(무시): {e}")
        self.arduino.send_json_line({"cmd": CMD_TASK, "task": task})
        print(f"[TASK] cell={cell} {final_status} -> {task} 전송")
        # 현재 작업(action)을 AWS로 보고 - 대시보드가 OBSERVE/REPLACE/SKIP를 표시한다(실패해도 무시).
        if self.cfg.aws_enabled and self.current_task is not None:
            self.cloud_sync.try_send(
                self.cloud.post_progress,
                robot_id=self.cfg.robot_id,
                task_id=self.current_task["id"],
                target=f"cell_{cell}" if cell is not None else None,
                state=STATE_VISION_READY,
                progress=self._cell_progress_percent(cell),
                action=task,
            )
        # 다음 셀을 위해 누적 리셋.
        self._inspect_cell = None
        self._inspect_results = []

    def _target_view_count(self) -> int:
        # [B 통일] 촬영할 View 수는 SQLite system_config.max_view에서 읽는다.
        # 운영 정책값이므로 confidence_threshold와 같은 계층(system_config)에서 관리하며,
        # Dashboard에서 조정할 수 있다. DB가 없거나 값이 없으면 INSPECTION_VIEWS 개수(4)로 폴백.
        default = len(INSPECTION_VIEWS)
        if self.state_db is None:
            return default
        try:
            return self.state_db.get_config_int("max_view", default)
        except Exception:
            return default

    def _cell_progress_percent(self, cell) -> int:
        # 현재 Cell 번호 / 전체 Cell 수(system_config.total_cells) 로 진행도(%)를 계산한다.
        # cell이 없으면(예: RUN 시작) 0. total_cells가 없거나 DB가 없으면 5로 폴백.
        if not cell:
            return 0
        total = 4
        if self.state_db is not None:
            try:
                total = self.state_db.get_config_int("total_cells", 4)
            except Exception:
                total = 4
        if total <= 0:
            return 0
        return min(int(round(cell / total * 100)), 100)

    # COMPLETE: 현재 Cell 작업 완료. AWS로 완료 보고.
    def _on_complete(self, msg: Dict[str, Any]) -> None:
        print(f"[COMPLETE] {msg}")
        cell = msg.get("cell")
        cycle_id = self.current_task["id"] if self.current_task else None
        self._db_update(cycle_id=cycle_id, cell_id=cell, state="COMPLETE", status="COMPLETE")
        # 마지막 셀 완료면 Cycle 종료 → Mega가 returnToHome 후 IDLE로 복귀한다.
        # [연속 순회] Mega가 IDLE로 돌아올 시간(returnToHome)을 준 뒤 다음 사이클을 자동 시작한다.
        # 리스너 스레드를 막지 않도록 Timer로 지연 실행(그 사이 PONG 수신 계속).
        total = self.state_db.get_config_int("total_cells", 4) if self.state_db is not None else 4
        if cell is not None and cell >= total:
            self.cycle_active = False
            self._cycles_done += 1
            target = self.state_db.get_config_int("cycle_count", 0) if self.state_db is not None else 0
            if target > 0 and self._cycles_done >= target:
                print(f"[CYCLE] 목표 사이클 {target}회 완료({self._cycles_done}) - 순회 종료")
            else:
                extra = f" (목표 {target}회 중)" if target > 0 else " (무한 반복)"
                print(f"[CYCLE] {self._cycles_done}회 완료{extra} - 3초 후 다음 사이클")
                threading.Timer(3.0, self._begin_new_cycle).start()
        if self.cfg.aws_enabled and self.current_task is not None:
            self.cloud_sync.try_send(
                self.cloud.post_response,
                robot_id=self.cfg.robot_id,
                task_id=self.current_task["id"],
                execute_task="CYCLE",
                completion_sign="DONE",
                message="Mega cell complete",
                payload={"mega_report": msg},
            )

    # SQLite current_task 갱신 헬퍼. DB가 없거나 실패해도 로봇 동작은 절대 막지 않는다.
    def _db_update(self, cycle_id=None, cell_id=None, state=None, task=None, view=None, status="RUNNING") -> None:
        if self.state_db is None:
            return
        try:
            self.state_db.update_current_task(
                cycle_id=cycle_id, cell_id=cell_id, state=state, task=task, view=view, status=status
            )
        except Exception as e:
            print(f"[SQLite] 상태 저장 실패(무시): {e}")

    # ERROR: Mega 내부 런타임 에러. AWS로 보고(에러 코드 포함).
    def _on_error(self, msg: Dict[str, Any]) -> None:
        code = msg.get("code", "UNKNOWN")
        print(f"[!!!] Mega ERROR: code={code} raw={msg}")
        if self.cfg.aws_enabled and self.current_task is not None:
            self.cloud_sync.try_send(
                self.cloud.post_response,
                robot_id=self.cfg.robot_id,
                task_id=self.current_task["id"],
                execute_task="ERROR",
                completion_sign="ERROR",
                message=f"Mega error: {code}",
                payload={"mega_error": msg},
            )

    # 병해충 의심 판독 시 AWS 판단 요청 + 관리자 응답 폴링. treat면 원래 status, ignore면 healthy.
    # [Phase C] inspection_views: 4 View 판독 결과. 판단요청에 실어 관리자가 표로 검토.
    def _await_admin_decision(self, status: str, vision_event_id: Optional[str], inspection_views=None, cell=None) -> str:
        if vision_event_id is None:
            print(f"[!!!] vision 이벤트 기록 실패로 판단 요청 불가 - 원래 판독값({status})으로 진행")
            return status

        try:
            req = self.cloud.create_decision_request(self.cfg.robot_id, vision_event_id, status,
                                                     inspection_views=inspection_views, cell=cell)
        except Exception as e:
            print(f"[!!!] 판단 요청 생성 실패 - 원래 판독값({status})으로 진행: {e}")
            return status

        request_id = req.get("id")
        self.awaiting_decision = True
        print(f"[대기] 병해충 의심({status}) 판단 요청 생성(id={request_id}) - 관리자 응답 대기...")
        # 대시보드에 "WAIT"(관리자 승인 대기)로 표시되게 보고(실패해도 무시). 실제 cell을 싣는다.
        if self.cfg.aws_enabled and self.current_task is not None:
            self.cloud_sync.try_send(
                self.cloud.post_progress,
                robot_id=self.cfg.robot_id,
                task_id=self.current_task["id"],
                target=f"cell_{cell}" if cell else None,
                state=STATE_VISION_READY,
                progress=self._cell_progress_percent(cell) if cell else 0,
                action="WAIT",
            )

        publisher = None
        get_shared_camera = getattr(self.vision, "get_shared_camera", None)
        if get_shared_camera is not None:
            try:
                from robot.webrtc_publisher import DiseaseStreamPublisher

                publisher = DiseaseStreamPublisher(self.cloud, get_shared_camera(), self.cfg.robot_id)
                publisher.start(request_id)
                print("[스트림] 관리자용 라이브 영상 세션 시작 시도")
            except Exception as e:
                print(f"[!] WebRTC 스트림 시작 실패(무시): {e}")
                publisher = None

        try:
            while True:
                time.sleep(DECISION_POLL_INTERVAL_SEC)
                try:
                    resolved = self.cloud.get_decision_request(request_id)
                except Exception as e:
                    print(f"[!] 판단 요청 조회 실패, 재시도: {e}")
                    continue
                if resolved and resolved.get("status") != "pending":
                    decision = resolved.get("status")
                    print(f"[재개] 관리자 판단 수신: {decision}")
                    return status if decision == "resolved_treat" else "healthy"
        finally:
            self.awaiting_decision = False
            self.last_pong_time = time.monotonic()  # 대기 끝난 직후 오프라인 오판 방지
            if publisher is not None:
                try:
                    publisher.stop()
                except Exception as e:
                    print(f"[!] 스트림 종료 중 오류(무시): {e}")

    def run_forever(self) -> None:
        # 리스너/하트비트 스레드가 모든 일을 하므로 메인은 살아있기만 하면 된다.
        try:
            while True:
                time.sleep(1.0)
        finally:
            self.close()

    def close(self) -> None:
        try:
            if getattr(self, "stream_server", None) is not None:
                self.stream_server.close()
        except Exception:
            pass
        try:
            self.arduino.close()
        except Exception:
            pass
        try:
            self.vision.close()
        except Exception:
            pass
