Leechanyeop/STREW-VISION/(commit log)

2026-06-30 Base
    6/30
    [results.csv]
2026-07-07 20260708
    Jetson↔Mega 통신을 7필드 방식에서 {"command", "target"} 2필드 방식으로 전환하고,
    프로젝트 시작부터 한 번도 실행 흐름에 연결되지 않았던 planner.plan_task()(Decision
    Engine)를 state_machine.py에 최초로 연결함. Mega의 다단계 진행상황 응답
    (RECEIVED~COMPLETE)을 스트리밍으로 처리하는 구조로 uart.py/state_machine.py를
    재설계함.
    변경 사항
    robot/command.py
    ArduinoCommand를 7개 필드(task_id, execute_task, move_sign, target_label,
    detected_label, x_center, y_center) → 2개 필드(command, target)로 축소.
    asdict()가 필드명을 그대로 JSON 키로 사용하므로 필드명 자체를 신규 인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
    [(1EA)1-BFP-00_Belt fixing plate.stl, (1EA)1-BP-00_Bord Plate.stl, (1EA)1-BP-01_Base Plate.stl, (1EA)1-CCB-00_Cable Chain Bracket.stl, (1EA)1-DjbB-00_Dual Joint Box Base.stl, (1EA)1-IB-00_Idler Block.stl, (1EA)1-IB-01_Idler Block.stl, (1EA)1-JBC-01_Joint Box Cover.stl]
2026-07-15 ## 변경 사항
    ### robot/command.py
    - 메시지 상수를 8종으로 확장: `MSG_START_CYCLE`, `MSG_REQUEST_VISION`, `MSG_VISION_RESULT`,
    `MSG_PROGRESS_UPDATE`, `MSG_REPORT_RESULT`, `MSG_CYCLE_COMPLETE`, `MSG_ERROR`, `MSG_RESET`.
    - 셀 하나만 지정하던 `MSG_ASSIGN_TARGET`은 순회 전체를 트리거하는 `MSG_START_CYCLE`로 대체(폐기,
    추적용으로 상수만 보존).
    - 구버전 2필드(`command`/`target`) 프로토콜의 `ArduinoCommand` 데이터클래스 — 코드 전체에서
    참조 없음을 grep으로 확인 후 **삭제**.
    ### robot/uart.py
    - `ArduinoLink.__init__`에 `self._write_lock = threading.Lock()` 추가.
    - `send_json_line()` 본문을 `with self._wr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
2026-07-19 Resolve packet.py merge conflict
    [packet.py]
2026-07-23 Jetson full sync: protocol v1.0 + OTA + py3.6 compat + auto-branch
2026-07-25 Phase A: Jetson SQLite state DB (Source of Truth) + state_machine wiring
2026-07-26 JSON 디코딩 오류랑 Mega Offline/복구 반복이 없어지고 안정적으로 Online 유지
2026-07-26 로봇이 사이클 시작 시 task를 스스로 생성 (create_task) → 진행도가 붙을 대상 확보 → 대시보드에 뜸.
2026-08-02 chore(config): use TensorRT engine as default model
    [(1EA)1-BP-01_Base Plate_0720.stl, (1EA)1-SRP-00_Servo rotary plate_0719.stl, (1EA)_Spur gear11_0719.stl, (2EA)1-PC-00_Pi Camera_0614.stl, (4EA)1-SA-00_Servo Arm_0719.stl, (4EA)Gripper_3.stl, 0727(1EA)Gripper_5.stl, 0727(1EA)_1-SA-04_Servo Arm.stl]
